DroningOn/ECE411/ECE 411 Presentation/Prototype Button.jpg

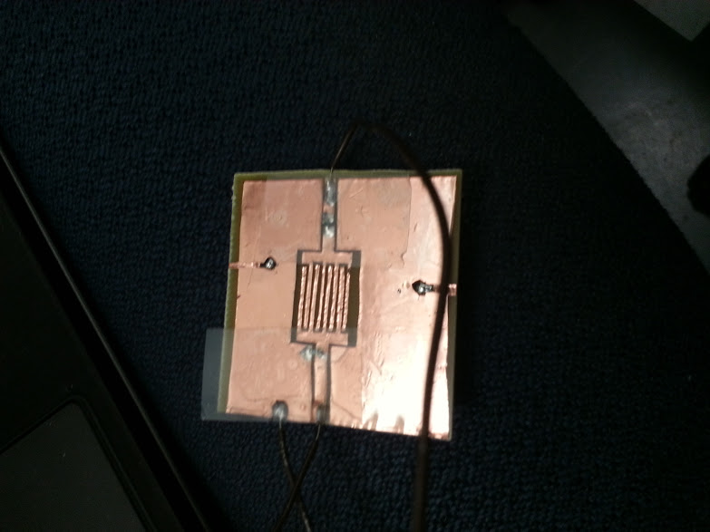
ECE 411 Presentation/Prototype Button.jpg
