DroningOn/ECE411/README.md

ECE411 Practicum Project
========================

**Project Focus:** Classroom Interactive Device

**Team:** Chris Halseth, Kyle Lu, Matt Downey, Michael Schmidt

**Advisor:** Andrew Greenberg

**Schematics and Layout**
(right click, save link as)

* [Satellite Board Schematic] (https://raw.githubusercontent.com/DroningOn/ECE411/master/Eagle/Schematics%20&%20Board%20Layout/Tx%20Board%20Schematic/T08-TxClicker-Rev1a.sch)

* [Satellite Board Layout] (https://raw.githubusercontent.com/DroningOn/ECE411/master/Eagle/Schematics%20&%20Board%20Layout/Tx%20Board%20Schematic/T08-TxClicker-Rev1a.brd)
