DroningOn/ECE411/ECE 411 Presentation/T08Presentation.pptx

## Wireless Classroom Clicker

Portland State University
Team: T08

Notes: Introduce Team:

Kyle Lu Chris Halseth Michael Schmidt Matt Downey

## Slide 2

1
Project Description
2
Motivation
3
Implementation
4
Results

Notes: Key Idea: What are we going to talk about?

## Project Description

  - Classroom Clicker System

ResponseCard NXT

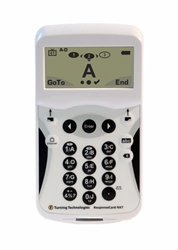
[picture p2: figure]

$59.50

iclicker +

$45

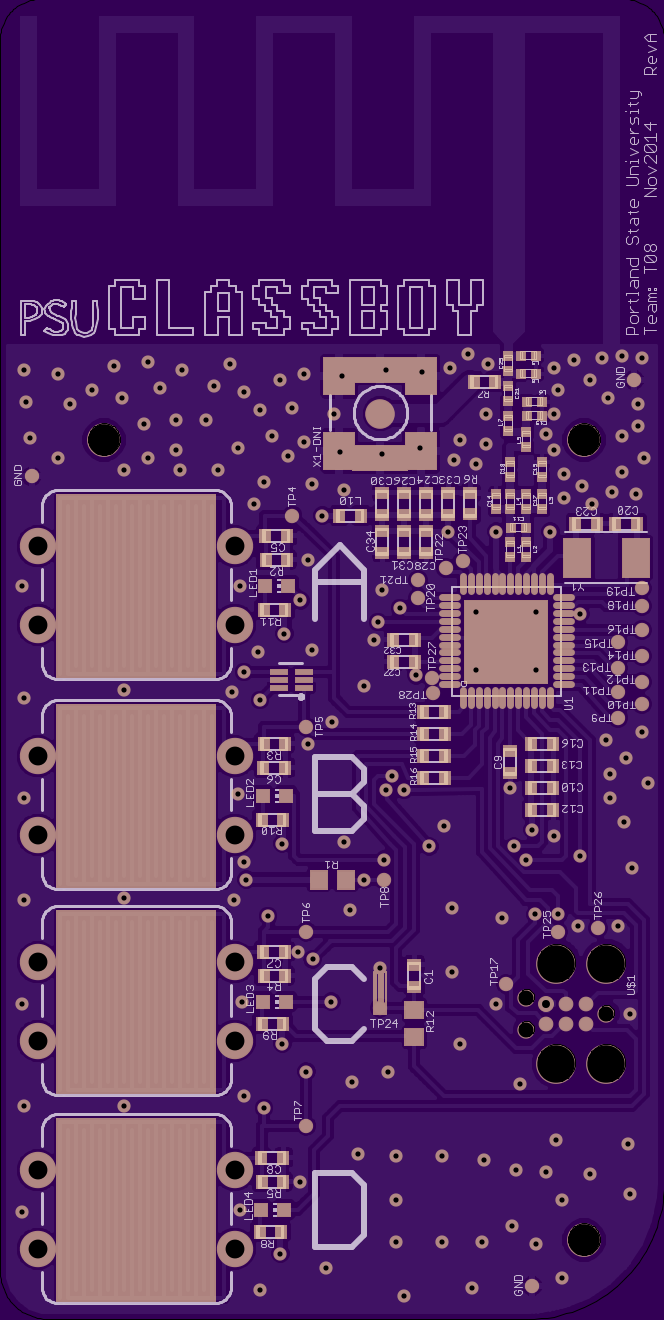
[picture p3: figure]

$9.40

Notes: Key Idea: What is a classroom clicker?

Facilitate real-time feedback system for data polling

## Motivation

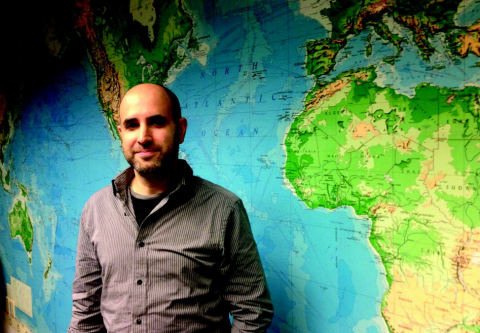
[picture p4: figure]

Notes: Key Idea: Andrew solicited the class to build a system with his specifications

1st week of class

## Requirements

- Primary
  - Cost Sensitive <$15
  - Minimum 100 Simultaneous Devices
  - Reliable: <0.1% Loss of Votes
  - Range: Lecture Hall

Notes: Key Idea: Primary Design Requirements

## Implementation

- Satellite
- Base Station
- Python GUI
  - PC Platform

Notes: Key Idea: Modules that were developed for this system

Long Operational Lifetime
2-Way Radio
ISM Band 915 MHz

## Implementation

- Satellite
- Base Station
- Python GUI
  - PC-Platform

Notes: Key Idea: Modules that were developed for this system

## Implementation

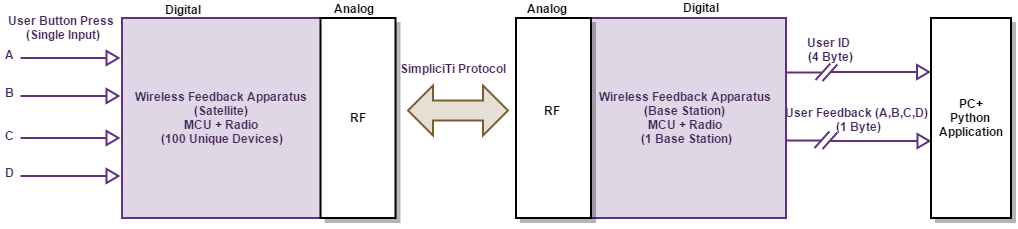
[picture p5: figure]

Notes: Key Idea: Functionality

What are the inputs/outputs
How are we transmitting data

## Satellite Flow Chart

Sleep Till Button Press

Flash All LED

n

Connected

n

Flash 4x LED

Attempt Reconnect

Get ACK

n

y

y

Tried 5 Times

Send Packet

n

y

y

n

CNT Base

Sleep Till Button Press

Form Packet

Send Packet

Get ACK

Init System

Connected

y

Button LED 2x

Notes: Key Idea: Modules that were developed for this system

## Python GUI Flow Chart

INIT Serial Port

Open Excel Workbook

Init GUI

CNT Base

Update Polling Duration

GUI Main Loop

Reset Bar Graph

Open Polling Loop & Init Count

Close Polling Loop

Close GUI, Serial Port, & Workbook

Display Results

Write Totals to Workbook

Count Answers

## Schematic

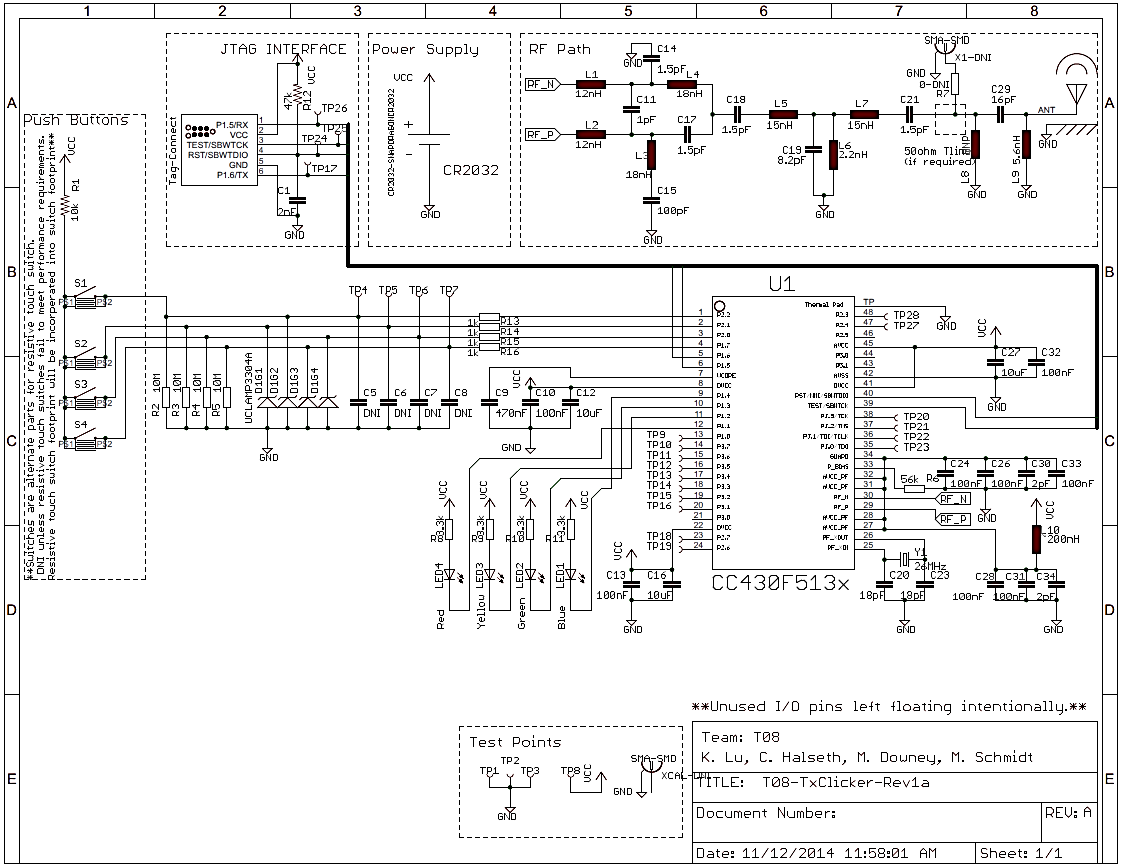
[picture p6: figure]

## Board Layout

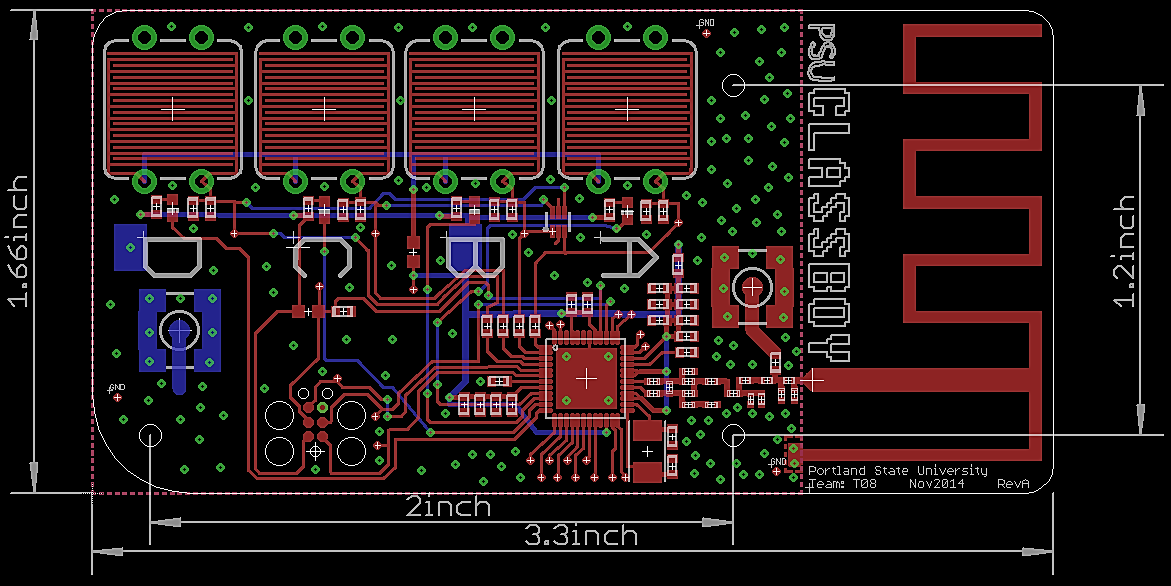
[picture p7: figure]

## Board Layout


## Testing Strategy

- Level 1: Unit Testing
- Level 2: Integrated Testing
- Level 3: System Testing

## Testing Strategy

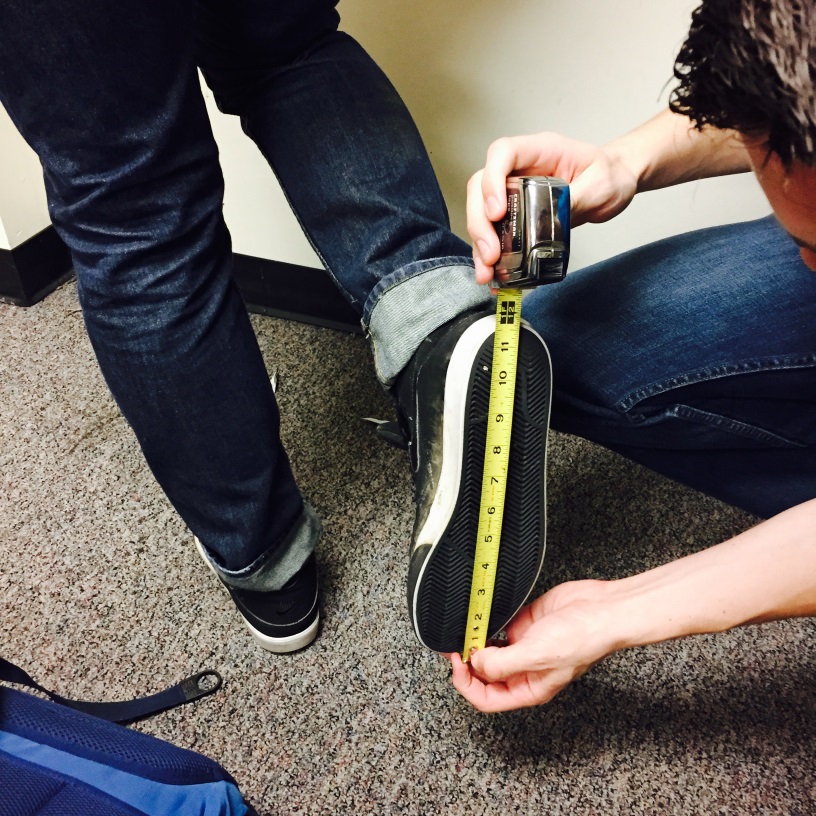
[picture p8: figure]

Notes: 0.96ft /Michaelfoot ~150

## IP and Prior Work

- Python Modules
  - PySerial, Time, CSV, TkInter
- MSPExp430F6137Rx User Experience
- MSPExp430F5137Rx User Experience
- Texas Instruments SimpliciTI Protocol

## Contributions

K. Lu System Level Design Schematic/PCB Layout Construct 4x Boards Bill of Materials Documentation Review | C. Halseth RF Antenna Design Resistive Button Design Base Station Program Satellite Program ~1000 Lines of Code PCB Layout
M. Schmidt Python GUI Development ~380 Lines of Code Developed Export Data Algorithm System Test & Verification | M. Downey System Test & Verification System Documentation Code Review

## Demonstration

- Q1: “wow, such cheap, much click, very engineer, so antenna, wow!”
- Press: A, B, C, or D

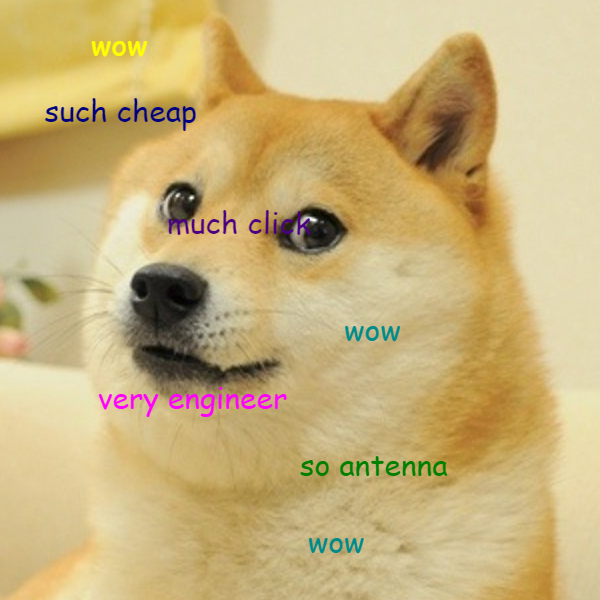
[picture p9: figure]
