DroningOn/ECE411/Antenna_Design/ECE411Antenna_wrk/SimulationLayout.pdf

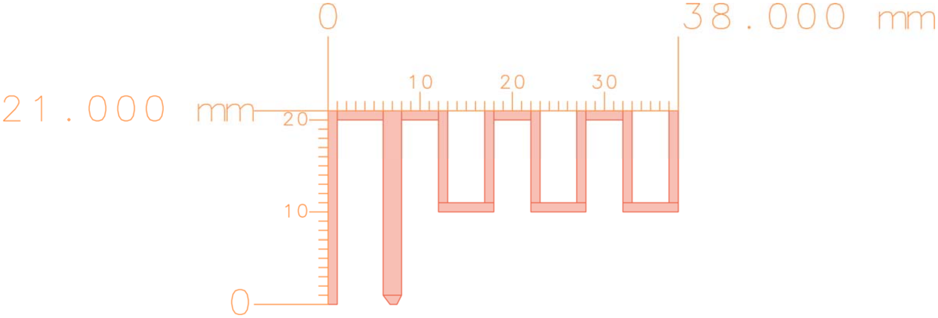
[picture p10: figure]
