DroningOn/ECE411/WikiMaterials/WPR/Team WPR.docx

Chris Halseth

WPR 2014-10-26

Last Week

Designed, simulated PCB antenna and matching network

Implemented full RF section in schematic/layout (chip->balun->match->antenna)

Tested CC430 dev kit functionality (*see issues)

Wrote simple program for turning on/off LED on dev kit with switch using CCS(TI IDE)

Created low cost resistive button prototype, tested on Arduino platform, decent results

Next Week

Isolate emulator/programming interface on dev kit for breakout

Set up dev kit to pass serial information via USB

Implement resistive button prototype in layout

Issues

Dev kit unable to connect wirelessly using demo program, strongly suspect radio is damaged on base board or

satellite. Recommend RMA ASAP so I can hash out/test wireless protocol in functioning environment.

================================================================================

Last Week (2014-11-02)

Isolate emulator/programming interface on dev kit for breakout

Set up dev kit to pass serial information via USB (software written not tested)

Ordered new dev kit

Next Week

Implement resistive button prototype in layout

Test serial interface when dev kit arrives and verify wireless link

Reoptimize antenna with current layout

Issues

Dev kit RMA slowed things down

Competing responsibilities this week pushed layout work out

Need to hash out serial interface data spec so front/back end has a unified design goal

================================================================================

Last Week (2014-11-09)

Layout work..a lot of it. Design finished, shipped.

Implemented resistive button layout.

Re-optimized antenna for current layout.

Setup serial interface on dev kit.

Tested wireless link, failed to connect.

Hashed out rough outline of serial comm spec with team.

Next Week

Isolate wireless connection issue(hopefully fix).

Write interrupt, operation, sleep routine skeleton.

Create fake data spew program for base board to provide a test basis for front end.

Issues

Second dev kit came in, same issue as last. EMI?Requires troubleshooting.

Will need access to a VNA and surface mount SMA launches when boards come in for match network cal.

Time, sleep, moral, etc.

================================================================================

WPR 2014-11-16

Last Week

Isolated wireless network connection issue and fixed.

Created functional skeleton program-- Sleep->ButtonInterrupt->Wake->TX->Verify->Sleep

Used/modified SimpliTI API to create robust network to handle errors and reconnects.

Worked on fake data program (unfinished)

Worked on isolating satellite device address from incoming packets on base station(unfinished)

Scheduled VNA access for Friday 21Nov (antenna verification, matching network optimization)

Next Week

Finish data spew program and pass off

Test antenna on VNA (cross fingers ADS is semi accurate with my models)

Calculate matching network from VNA measurements

Stuff board on Friday

If TagConnect cable shows up finally, program a board and do some verification

Issues

TagConnect cable not here yet.

Three weeks.... lot of unknowns and lots to do.

Isolating device address on incoming packets taking a bit of API/network layer rewrite, time consuming.

Simultaneous device support tests not really possible (eg. we don't have 500) don't know how to test currently besides using a separate device to flood the channel, but this is a bad approximation because it isn't exercising base station handle of many tokens/frame scheduling/etc

================================================================================

WPR 2014-11-23

Last Week

Data spew program cancelled due to priorities, text file substituted

VNA tests on one board, antenna trimmed and match calculated

Two boards stuffed

Hacked together preliminary firmware for satellite, initial tests good(yay network works)

Next Week

Get functional versions of base and satellite code up and running

Troubleshoot issues as they arise

Hand off system for testing

Issues

Bit of a non-issue but noticed the trimmed antenna is worse than untrimmed antenna in RSSI, perhaps VSWR measurement was fouled by proximity of SMA cable port.

================================================================================

Last Week (2014-11-30)

Wrote and tested functional base station code

Wrote and tested functional satellite code

Performed preliminary range tests

Handed off functional satellite/base combo for testing with GUI frontend

Troubleshot button code glitch

Next Week

Get ESD protection on boards

Test/verification/load firmware/(repair if needed) next two boards

Test cases and measurements with batteries installed

Clean up project code and have a team review for it

================================================================================

Last Week (plus most of another, finals) (2014-12-12)

Firmware load/test/verification/repair of other two boards

Test cases and measurements with batteries installed

Cleaned up project code and have a team review for it

Modification to base station to handle 100 devices

Test code created for 100 device verification

Bug squashing on satellites and base station

Sleep between blinks code to save battery implemented

Presentation preparation

Presentation delivered

Mostly maintained sanity

Kyle Lu

Last Week (2014-10-26)

Finished schematic

Completed BOM

Next Week

Order Parts

Order Boards

Issues

Decide on Tag-Connect

Decide on Tx enclosure

====================================================================================

Last Week (2014-11-02)

Started PCB Layout

Edited schematic per suggestions from ADG

Next Week

Finalize PCB layout (due Wednesday)

Finalize BOM

Design for test review

Issues

Delayed Digikey parts order until final board review from team + ADG

====================================================================================

Last week (2014-11-9)
---------------------------------------------------------------------------------------------------------------------------------------------------
Continued working on layout/editing (push-pull-push-pull)
Submitted PCBs to OSH Park.

This week
---------------------------------------------
Order parts
Look at GUI?

====================================================================================

Last Week (2014-11-16)

Ordered Parts

Created System Level 0, Level 1 Diagrams

Created UML Model of Button Press Activity

This Week

Stuff Boards

Debug Boards

Create a Test Plan

Create Validation Documentation

Issues

Must add CR2032 battery costs to BOM

Only 3 weeks left.

====================================================================================

Last Week (2014-11-30)

Formalize test plan documentation

Defined scope of test plan

Linked 'design' documentation

Linked 'other' documentation

Linked FCC & Industry standards documentation

Assigned test case #s

This Week

Stuff two additional boards

Review system documentation & verify req'm are met

Perform test cases & record results

Issues

====================================================================================

Last Week (2014-11-21 post hoc)

Stuffed 2x boards for test & debug

This week

Thanksgiving

Issues

This is a post hoc WPR.

====================================================================================

Last week (2014-12-12)

Prepared presentation

Delivered presentation

Closed outdated action items on github

Went to many ece 411 presentations throughout Thursday and Friday.

Downloaded and installed gui on multiple computers to ensure that it works on different machines.

Issues

Failed to meet sleeping requirements.

Failed some coffee requirements.

Finals or presentations every day (except) Thursday.

Michael Schmidt

WPR 2014-10-26

Last Week

Researched feasibility of wxPython as GUI dev wrapper

Researched Pyserial module for serial com to base station

Next Week

Prototype wxPython GUI

Attempt serial communication using Pyserial module

Order CR2032 batteries for transmitters

====================================================================================

WPR 2014-11-03

Last week
------------------------------
- Switched from wxPython to Tkinter for GUI development
- Successfully prototyped GUI module that displays data in a bar graph
- Decided on pyusb module for reading data over usb

Next Week
-----------------------
- Work on project schedule with Matt
- Further research pyusb
- Run a usb "Hello, World!" with pyusb

====================================================================================

WPR 2014-11-12

Last Week

- Write, Review and Revise project schedule

- Further GUI Research

This Week

-Finalize GUI Layout

-Begin writing GUI functions

-Research packet format from base station

-Begin packet parser pseudocode

====================================================================================

WPR 2014-11-16

Last Week

Wrote Model and System Diagram Doc

Finished Pseudocode for Parser

Wrote rev 1 of software application

Started preliminary testing of software application

Next Week

Write test plan

Add additional GUI elements

Test parser with Chris's data spew program

Write rev 2 of software application

====================================================================================

WPR 2014-11-23

Last Week

Test parser

Add GUI elements

This Week

Added GUI widgets

Create event handlers for widgets

Write poll loop

Test plan

====================================================================================

WPR 2014-11-30

Last Week
--------------------------
-Added GUI widgets (start button, stop button, countdown timer, percentages on bar graph, drop down for polling duration)
-Implemented event handlers for all widgets
-Rewrote newParse method to include polling loop.
-Successfully interfaced software application with base station
-Assist in writing test plan

This week
---------------------
-Implement file output in software application (.csv or .xslx)
-Add different graph methods (horizontal bar, pie chart)
-Clean up code and finish comments
-Execute test plan to verify requirements

====================================================================================

WPR 2014-12-7

Last week

- Added excel readable csv output

- clean up code and added comment

- Some testing

This Week

- Finish testing

- Finish commenting

- Work on presentation

- Present !

====================================================================================

WPR 2014-12-12

Last Week
----------------------
Finalized GUI
Finished testing
Prepared Presentation
Delivered Presentation
Done!

Matt Downey

WPR 2014-10-26

Last Week

Researched GUI language options

Conducted GUI concept discussion with Kyle

Next Week

Conduct feasibility of GUI languages compatibility to MCU (wrappers)

RMA dev kit

Continue GUI concept discussions

=========================================================================================

WPR 2014-11-2

Last week

Resolved dev kit RMA issues. Chris to buy new part, Matt to get money back for original.

Assisted in completion of PDS report.

Next week

Conceptual layout of GUII

Assist in project timeline

========================================================================================

WPR 2014-11-12

Last week

Assisted with creation of project timeline documentation

Initiated team conversation about serial comm spec with team

Suggested contact with Dr. Campbell for access to VNA

Next Week

Code party with Michael

System Design and Model documentation

========================================================================================

WPR 2014-11-30

Last Week

Wrote parts of test plan.

Reviewed and Revised Test plan.

Next Week

Final Thursday 12/4

Complete tests to prove Design Specs

Group Meeting Saturday 1pm
