DroningOn/ECE411/WikiMaterials/HWDocuments/ECE411HW6.pdf

### ECE 411 Industry Design Processes: Assignment #6 Due on Monday, November 24, 2014 Faust 2:00pm

T08

### K. Lu, C. Halseth, M. Schmidt, M. Downey

https://github.com/DroningOn/ECE411

Homework #6 Due Monday November 24, 2014 ***Please submit problems into the team wiki homework #6 folder on GitHub as well as a paper copy in class.***

Grading Schema:
Your work will be graded on completeness, conformance to design documentation requirements as described in class, and quality and clarity of the individual test cases.

Problem 1:
Create a comprehensive hierarchical test plan for your practicum project. Consult the course lecture notes and textbook for guidelines.

# Wireless Feedback Apparatus

Test Plan Documentation

Rev. 201411.R1

The information presented in the T08 test documentation in the alpha phase of development. Although this document has been carefully checked and is believed to be accurate, no responsibility is assumed for inaccuracies.

Introduction
In Scope
Out of Scope
Reference Documents
Design Documentation
Other Documentation
Overview of Testing Approach Levels of Testing
Level 1: Unit Testing
Level 2: Integrated Testing Level 3: System Testing
Testing Definitions
Operational Description
Definition of Terminology
Computation Methods
Pretest Preparation
Test Equipment
Test Setup and Calibration
System Tests
Level 1: Unit Testing
L1-F01-A-A: Visual Inspection of reflowed boards L1-F02-A-A: Radio Frequency ISM Band Test L1-F03-A-A: Current Consumption Test L1-F04-A-A: MCU LED Response Test L1-F05-A-A: GUI Functionality Test L1-P01-A-A: RF Scattering Parameters L1-P02-A-A: RSSI
L1-P03-A-A: Power output (dBm) L1-R01-A-A: Button Press Counter L1-R02-A-A: Tx Packet Counter L1-R03-A-A: Real-Time Packet Parsing L1-R04-A-A: Data Storage Validation Test
Level 2: Integration Testing
L2-F01-A-A: Transmit Packet Test
L2-F02-A-A: Integrated Power Consumption Test L2-F03-A-A: Return to Sleep Mode Test L2-F04-A-A: Populate Network Test L2-F05-A-A: Interface Python GUI to Base Station L2-F06-A-A: Connect to Network on Reset L2-F07-A-A: Connect to Network on Power Up L2-F08-A-A: Connect to Network after Loss of Power L2-P01-A-A: RSSI

L2-P02-A-A: Connectivity
Level 3: System Testing
L3-F01-A-A: Button Press Indicator L3-F02-A-A: Usability Test L3-F03-A-A: End to End Hardware L3-F04-A-A: GUI Statistics Report L3-F05-A-A: GUI Start/Stop Polling L3-F06-A-A: GUI New Dataset L3-T01-A-A: User Input Test L3-T02-A-A: Ease of Use Test
L3-R01-A-A: Repeatability Test
L3-R02-A-A: Battery Lifetime
L3-R03-A-A: Channel Noise Connectivity Test

## 1. Introduction

The purpose of the product test plan is to document how the product will be tested to ensure that it conforms to the project scope and meets the engineering requirements specified in the Product Design Specification (PDS) document.

In Scope
This document addresses the procedures necessary for proper system testing and verification related to the design of the wireless classroom feedback product. The product testing plan includes the following modules described in detail by the PDS.
- Operational Requirements
- Functionality Requirements
- Performance Requirements
- Interface Requirements
Out of Scope
The following items are outside of the scope of the initial project and may be addressed by subsequent practicum design projects.
- Verification of all FCC regulations pertaining to short-range wireless communication devices (47CFR20).
- Characterization of antenna directivity and radiation efficiency
- Six-Sigma Testing Methodology

## 2. Reference Documents

Refer to the following reference documentation for the detailed documentation about specific testing guidelines and standards.

### 2.1. Industry Standards

- FCC guidelines, Radiofrequency radiation exposure limits. (http://www.ecfr.gov/cgi-bin/text-idx?SID=5cafd53f1d764142f00e1b9f3a8ddcdf&node=se47.1.1_11310&rgn=div8)
- (47CFR1.1310)
- FCC Regulations, Title 47- Telecommunications (http://www.fcc.gov/encyclopedia/rules-regulations-title-47)
- (47CFR20)

### 2.2. Design Documentation

- Product Design Specifications (PDS) (https://github.com/DroningOn/ECE411/blob/master/WikiMaterials/HWDocuments/ECE411T08HW3.pdf?raw=true)
- Block Level Diagram Document ( System Design / Modeling Document) (https://github.com/DroningOn/ECE411/blob/master/WikiMaterials/HWDocuments/ECE411T08HW5.pdf?raw=true)
- Eagle Circuit Schematic (https://raw.githubusercontent.com/DroningOn/ECE411/master/Eagle/Schematics%20&%20Board%20Layout/Tx%20Board%20Schematic/T08-TxClicker-Rev1a.sch)
- Eagle Board Layout (https://raw.githubusercontent.com/DroningOn/ECE411/master/Eagle/Schematics%20&%20Board%20Layout/Tx%20Board%20Schematic/T08-TxClicker-Rev1a.brd)

- Top/Bot Layer Reference (https://github.com/DroningOn/ECE411/blob/master/WikiMaterials/HWDocuments/ECE411T08HW6/Eagle%20Reference%20Docs/T08-TxClicker-Rev1a-top.pdf)
- Bot Layer Reference (https://github.com/DroningOn/ECE411/blob/master/WikiMaterials/HWDocuments/ECE411T08HW6/Eagle%20Reference%20Docs/T08-TxClicker-Rev1a-bot.pdf)
- Dimensions Layer Reference (https://github.com/DroningOn/ECE411/blob/master/WikiMaterials/HWDocuments/ECE411T08HW6/Eagle%20Reference%20Docs/T08-TxClicker-Rev1a-Dimensions.pdf)
- Component Outline Reference (https://github.com/DroningOn/ECE411/blob/master/WikiMaterials/HWDocuments/ECE411T08HW6/Eagle%20Reference%20Docs/T08-TxClicker-Rev1a-ComponentOutline.pdf)
- Bill of Materials (BOM) (https://github.com/DroningOn/ECE411/blob/master/Eagle/Schematics%20%26%20Board%20Layout/Tx%20Board%20Schematic/T08-TxClicker_BOM.xlsx)

### 2.3. Other Documentation

- Texas Instruments: SLAA276A-October 2006 (https://github.com/DroningOn/ECE411/blob/master/Active%20Datasheets/CC430%20to%20USB.pdf)
- Texas Instruments: ECCN 5A002A1A (https://github.com/DroningOn/ECE411/blob/master/Active%20Datasheets/CC430_DevKit_UserGuide.pdf)
- Texas Instruments: SLAA465C (https://github.com/DroningOn/ECE411/blob/master/Active%20Datasheets/CC430_RF_Examples.pdf)
- Texas Instruments: SLAU320P (https://github.com/DroningOn/ECE411/blob/master/Active%20Datasheets/MSP430%20Programming%20Via%20the%20JTAG%20Interface.pdf)
- Texas Instruments: DN024 (https://github.com/DroningOn/ECE411/blob/master/Active%20Datasheets/PCB_Antenna.pdf)
- Texas Instruments: Introduction to SimpliciTI (https://github.com/DroningOn/ECE411/blob/master/Active%20Datasheets/SimplicitiNetwork.pdf)
- Texas Instruments: SmartRF Studio (https://github.com/DroningOn/ECE411/blob/master/Active%20Datasheets/SmartRFStudio_Tutorial.pdf)
- Texas Instruments: CC430F5137 (https://github.com/DroningOn/ECE411/blob/master/Active%20Datasheets/cc430f5137.pdf)

## 3. Overview of Testing Approach

### 3.1. Levels of Testing

Levels of testing are implemented to detect and identify problems early in the product development cycle. By modularizing testing, many components may be verified and tested in parallel thereby speeding up product development and reducing development time kinks where teams or team members are left idle. Each level must first be validated and approved by the team or manager before elevating the test to the next level. In this document, three levels of testing are implemented. Each level as well as the test level objects are defined below.

### 3.1.1. Level 1: Unit Testing

This phase involves testing independent pieces of hardware and software. The unit test is performed to validate the design requirements specified in the PDS. Unit testing generally represents a single aspect of the design and is an easy way to show that the unit satisfies its functional specification.
- Objectives
- Perform detailed tests of all functional requirements
- “White” box testing passes
- “Black” box testing passes
- Meets all specifications described by PDS

### 3.1.2. Level 2: Integrated Testing

The integrated testing phase integrates unit modules in order to create more complex components. The purpose of this test is to discover whether the major modules of the overall system operate correctly together.

- Objectives
- Verify that performance specifications are maintained during integration phase
- Identify and fix problems prior to system testing

### 3.1.3. Level 3: System Testing

The system level test is used to determine if the product functions as specified by the PDS. In this phase, testers identify problems encountered in functionality where a given functional input does not produce the expected response.
- Objectives
- Ensure end device operates as expected and matches the intention of the design specification.
- Verify that functional and performance specifications are met.
- Verify that all items on test plan are performed successfully.
- Identify problems with the data

### 3.2. Operational Description

- Takes 1 of 4 user inputs and wirelessly transmits the selected input to a central hub where a results are serialized and handed off to software. The software takes the serialized data and displays it in graphical form.

### 3.3. Definition of Terminology

### 1. MCU : Microcontroller Unit 2. ID : Identification 3. DUT : Device Under Test 4. GUI : Graphical User Interface

5. Exhaustive Test: Testing approach in which all possible combinations of scenarios, use cases, and test cases are used in testing
6. Battery Lifetime: Total duration that a satellite unit can operate on a single, fully-charged CR2032 battery.
7. ISM Band Region 2: The unlicensed band from 902MHz to 928MHz.

### 3.4. Computation Methods

### 3.4.1. Power Consumption

- Device Current Consumption:
- Iaverage = I | x Ratio | x Ratio | I | x Ratio Standby | Standby
+ IActive | active + Peripheral | Peripheral
- Total Average Current Consumption:
- AvgI | AvgI | AvgI | vgI
total = | Standby
+ | Peripheral + A Active
- Battery Lifetime
- CR2032 uAh/AvgI
| total
■ 230000uAh/AvgI
| | | | | total

## 4. Pretest Preparation

### 4.1. Test Equipment

- Agilent Vector Network Analyzer
- Agilent 2-Channel Oscilloscope
- Fluke Multimeter
- Computer with Python installed
- Keithly Micro-ammeter
- CC430 DevKit
- ECE 411 Project Satellite Unit
- Base Station

### 4.2. Test Setup and Calibration

- Load firmware to MCU
- Install CR2032 to power Satellite unit
- Install “serial” and “Tkinter” python module

## 5. System Tests

The system TestID format shall be as follows: Level# - X(Test Type) Level#-TestTypeLetter XX - HardwareRev-Software Rev
- Level 1: Unit Testing
- Functional Testing
■ L1-F01-A-A: Visual Inspection of reflowed boards ■ L1-F02-A-A: Radio Frequency ISM Band Test ■ L1-F03-A-A: Current Consumption Test
■ L1-F04-A-A: MCU LED Response Test
■ L1-F05-A-A: GUI Functionality Test
- Parametric Testing
■ L1-P01-A-A: RF Scattering Parameters ■ L1-P02-A-A: RSSI
■ L1-P03-A-A: Power output (dBm)
- Reliability Testing
■ L1-R01-A-A: Button Press Counter
■ L1-R02-A-A: Tx Packet Counter
■ L1-R03-A-A: Real-Time Packet Parsing
■ L1-R04-A-A: Data Storage Validation Test

- Level 2: Integration Testing
- Functional Testing
■ L2-F01-A-A: Transmit Packet Test
■ L2-F02-A-A: Integrated Power Consumption Test ■ L2-F03-A-A: Return to Sleep Mode Test
■ L2-F04-A-A: Populate Network Test
■ L2-F05-A-A: Interface Python GUI to Base Station ■ L2-F06-A-A: Connect to Network on Reset
■ L2-F07-A-A: Connect to Network on Power Up
■ L2-F08-A-A: Connect to Network after Loss of Power
- Parametric Testing
■ L2-P01-A-A: RSSI
■ L2-P02-A-A: Connectivity
- Level 3: System Testing
- Functional Testing
■ L3-F01-A-A: Button Press Indicator ■ L3-F02-A-A: Usability Test
■ L3-F03-A-A: End to End Hardware ■ L3-F04-A-A: GUI Statistics Report ■ L3-F05-A-A: GUI Start/Stop Polling ■ L3-F06-A-A: GUI New Dataset
- Use Testing
■ L3-T01-A-A: User Input Test
■ L3-T02-A-A: Ease of Use Test
- Reliability Testing
■ L3-R01-A-A: Repeatability Test
■ L3-R02-A-A: Battery Lifetime
■ L3-R03-A-A: Channel Noise Connectivity Test

Problem 2:
Create detailed test case descriptions for four tests included in your test plan.

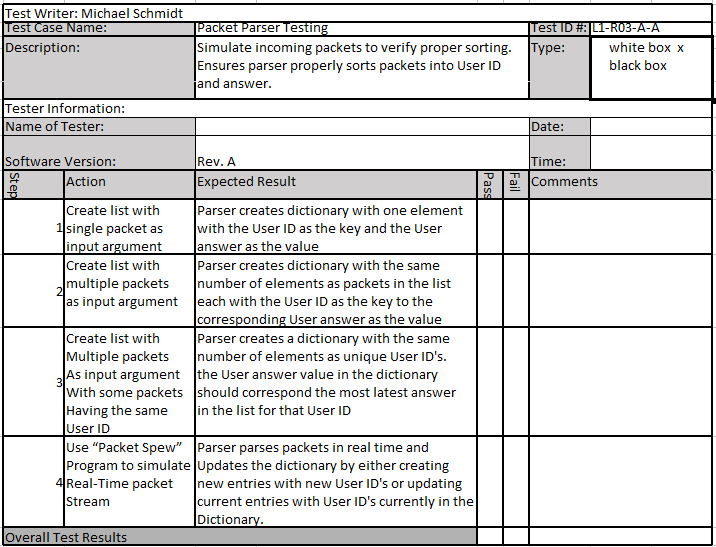
[picture p11: figure]

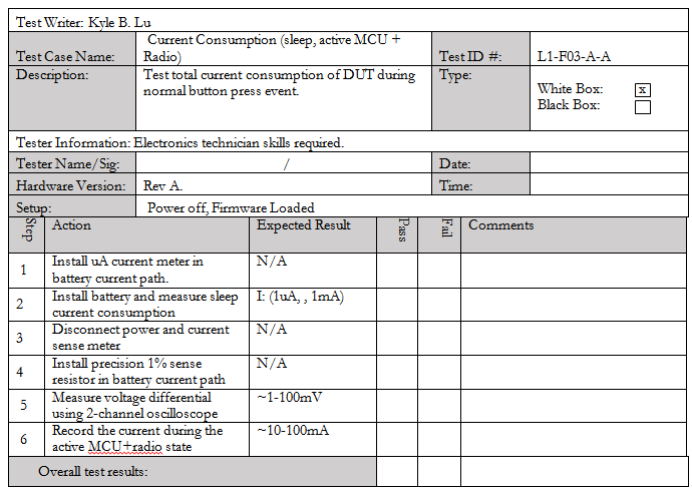
[picture p12: figure]

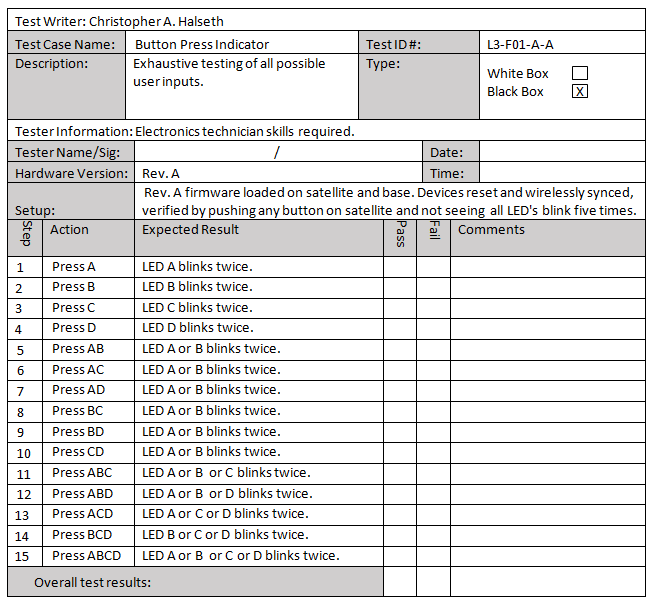
[picture p13: figure]

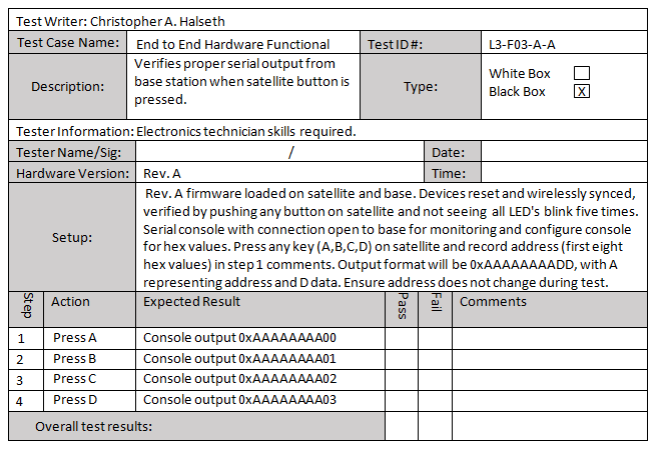
[picture p14: figure]
