DroningOn/ECE411/BOM/T08-TxClicker_BOM.xlsx

Sheet: T08-TxClicker_Rev1a
ECE 411 "Clicker" BOM, T08
Number of Boards | 4
Total Components/Build | Qty | Value | Parts | Description | Digikey# | Manufacturer | Manufacturer P/N | Unit Price | Extended Price @100x
112 | 28 |  | TP1, TP2, TP3,TP4, TP5, TP6, TP7, TP8, TP9, TP10, TP11, TP12, TP13, TP14, TP15, TP16, TP17, TP18, TP19, TP20, TP21, TP22, TP23, TP24, TP25, TP26, TP27, TP28 | COPPER TEST POINTS
16 | 4 | 1.5pF | C14, C17, C18, C21 | CAP CER 1.5PF 50V NP0 0402 | 490-5891-1-ND | Murata Electronics North America (http://digikey.com/Suppliers/us/Murata-Electronics.page?lang=en) | GRM1555C1H1R5CA01D | 0.1 | 0.011
32 | 8 | 100nF | C10, C13, C24, C26, C28, C31, C32, C33 | CAP CER 0.1UF 50V 10% X7R 0603 | 399-5089-1-ND | Kemet (http://digikey.com/Suppliers/us/Kemet.page?lang=en) | C0603C104K5RACTU | 0.1 | 0.0187
4 | 1 | 100pF | C15 | CAP CER 100PF 50V 1% C0G 0402 | 445-5362-1-ND | TDK Corporation | C1005C0G1H101F050BA | 0.45 | 0.1964
16 | 4 | 10M | R2, R3, R4, R5 | RES 10M OHM 1/10W 5% 0603 | RMCF0603JT10M0CT-ND | Panasonic Electronic Components | RMCF0603JT10M0 | 0.1 | 0.007
4 | 1 | 10k | R1 | RES 10K OHM 1/10W 1% 0603 | RMCF0603FT10K0CT-ND | Stackpole Electronics Inc | RMCF0603FT10K0 | 0.1 | 0.0105
12 | 3 | 10uF | C12, C16, C27 | CAP CER 10UF 16V 20% X5R 0603 | 490-7201-1-ND | Murata Electronics North America (http://digikey.com/Suppliers/us/Murata-Electronics.page?lang=en) | GRM188R61C106MA73D | 0.3 | 0.1967
8 | 2 | 12nH | L1, L2 | FIXED IND 12NH 640MA 120 MOHM | 732-1725-1-ND | Wurth Electronics Inc (http://digikey.com/Suppliers/us/Wurth-Electronics.page?lang=en) | 744765112A | 0.47 | 0.375
8 | 2 | 15nH | L5, L7 | FIXED IND 15NH 560MA 172 MOHM | 732-1727-1-ND | Wurth Electronics Inc (http://digikey.com/Suppliers/us/Wurth-Electronics.page?lang=en) | 744765115A | 0.47 | 0.375
4 | 1 | 16pF | C29 | CAP CER 16PF 50V 1% NP0 0402 | 399-8829-1-ND | Kemet | CBR04C160F5GAC | 0.34 | 0.1412
8 | 2 | 18nH | L3, L4 | FIXED IND 18NH 420MA 230 MOHM | 732-1729-1-ND | Wurth Electronics Inc (http://digikey.com/Suppliers/us/Wurth-Electronics.page?lang=en) | 744765118A | 0.47 | 0.435
8 | 2 | 18pF | C20, C23 | CAP CER 18PF 50V 1% NP0 0603 | 1276-2206-1-ND | Samsung Electro-Mechanics America, Inc (http://digikey.com/Suppliers/us/samsung-electro-mechanics.page?lang=en) | CL10C180FB8NNNC | 0.16 | 0.0527
16 | 4 | 1k | R13, R14, R15, R16 | RES 1K OHM 1/10W 1% 0603 SMD | P1.00KHCT-ND | Panasonic Electronic Components | ERJ-3EKF1001V | 0.1 | 0.0114
4 | 1 | 1pF | C11 | CAP CER 1PF 50V NP0 0402 | 1276-1595-1-ND | Samsung Electro-Mechanics America, Inc (http://digikey.com/Suppliers/us/samsung-electro-mechanics.page?lang=en) | CL05C010CB5NNNC | 0.1 | 0.0096
4 | 1 | 2.2nH | L6 | FIXED IND 2.2NH 960MA 70 MOHM | 732-1706-1-ND | Wurth Electronics Inc (http://digikey.com/Suppliers/us/Wurth-Electronics.page?lang=en) | 744765022A | 0.47 | 0.375
4 | 1 | 26MHz | Y1 | CRYSTAL 26MHZ 18PF SMD | 887-1508-1-ND | TXC CORPORATION (http://digikey.com/Suppliers/us/TXC-Corporation.page?lang=en) | 7A-26.000MAAJ-T | 0.79 | 0.525
4 | 1 | 2nF | C1 | CAP CER 2000PF 50V 5% NP0 0603 | 490-1458-1-ND | Murata Electronics North America (http://digikey.com/Suppliers/us/Murata-Electronics.page?lang=en) | GRM1885C1H202JA01D | 0.13 | 0.0428
8 | 2 | 2pF | C30, C34 | CAP CER MLO 2PF 50V NP0 0603 | 478-6717-1-ND | AVX Corporation | ML03512R0BAT2A | 0.6 | 0.2763
16 | 4 | 3.3k | R8, R9, R10, R11 | RES 3.3K OHM 1/10W 1% 0603 | RMCF0603FT3K30CT-ND | Stackpole Electronics Inc | RMCF0603FT3K30 | 0.1 | 0.0105
4 | 1 | 470nF | C9 | CAP CER 0.47UF 50V 10% X5R 0603 | 587-3171-1-ND | Taiyo Yuden | UMK107ABJ474KA-T | 0.11 | 0.0381
4 | 1 | 47k | R12 | RES 47K OHM 1/10W 1% 0603 | RMCF0603FT47K0CT-ND | Stackpole Electronics Inc | RMCF0603FT47K0 | 0.1 | 0.0105
4 | 1 | 5.6nH | L9 | FIXED IND 5.6NH 280MA 700 MOHM | 732-2921-1-ND | Wurth Electronics Inc (http://digikey.com/Suppliers/us/Wurth-Electronics.page?lang=en) | 744901056 | 0.38 | 0.2438
4 | 1 | 56k | R6 | RES 56K OHM 1/10W 1% 0603 | RMCF0603FT56K0CT-ND | Stackpole Electronics Inc | RMCF0603FT56K0 | 0.1 | 0.0105
4 | 1 | 8.2pF | C19 | CAP CER 8.2PF 50V NP0 0402 | 587-1946-1-ND | Taiyo Yuden (http://digikey.com/Suppliers/us/Taiyo-Yuden.page?lang=en) | UMK105CG8R2DV-F | 0.1 | 0.0099
4 | 1 | CC430F513X---RGZ48 | U1 | IC MCU 16B 32K W/RF CORE 48VQFN | 296-27420-1-ND | Texas Instruments | CC430F5137IRGZR | 6.97 | 2.96
4 | 1 | CR2032-SNAPDRAGONCR2032 | U$5 | HOLDER SNAP DRAGON CR2032 SMD | BHSD-2032-SMCT-ND | MPD (Memory Protection Devices) (http://digikey.com/Suppliers/us/Memory-Protection-Devices.page?lang=en) | BHSD-2032-SM | 0.9 | 0.7875
4 | 1 | Yellow | LED3 | LED YELLOW CLEAR THIN 0603 SMD | 160-1448-1-ND | Lite-On Inc (http://digikey.com/Suppliers/us/Lite-On.page?lang=en) | LTST-C191KSKT | 0.32 | 0.135
4 | 1 | Blue | LED1 | LED 1.6X0.8 470NM BL WTR CLR SMD | 754-1434-1-ND | Kingbright (http://digikey.com/Suppliers/us/Kingbright.page?lang=en) | APT1608QBC/D | 0.39 | 0.2113
4 | 1 | Green | LED2 | LED GREEN CLEAR THIN 0603 SMD | 160-1446-1-ND | Lite-On Inc (http://digikey.com/Suppliers/us/Lite-On.page?lang=en) | LTST-C191KGKT | 0.3 | 0.1296
4 | 1 | Red | LED4 | LED CHIPLED 633NM RED 0603 SMD | 475-2512-1-ND | OSRAM Opto Semiconductors Inc (http://digikey.com/Suppliers/us/Osram.page?lang=en) | LS Q976-NR-1 | 0.09 | 0.587
4 | 1 | PCB_ANTENNA_915MHZOSHP | U$6
8 | 2 | SMA-SMD | X1-DNI, XCAL-DNI | SMA 50 Ohm Straight Jack Receptacle - Surface Mount | CONSMA001-SMD-G-ND | Linx Technologies Inc (http://digikey.com/Suppliers/us/Linx-Technologies.page?lang=en) | CONSMA001-SMD-G | 2.86
4 | 1 | TC2030-MCP | U$1 | TAG-CONNECT ISP
16 | 4 | TOUCHPAD_SWITCH | S1, S2, S3, S4 | INTEGRATED PCB RESISTIVE SWITCH
4 | 1 | UCLAMP3304A | D1 | TVS DIODE 3.3VWM 8VC SC896 | UCLAMP3304ACT-ND | Semtech (http://digikey.com/Suppliers/us/Semtech.page?lang=en) | UCLAMP3304A.TCT | 0.57 | 0.33
4 | 1 | ~200nH | L10 | FIXED IND 200NH 120MA 2.4 OHM | 490-6929-1-ND | Murata Electronics North America (http://digikey.com/Suppliers/us/Murata-Electronics.page?lang=en) | LQW18ANR20G00D | 0.36 | 0.234
1 | PCB | N/A | OSH PARK Board/MyroPCB | N/A |  |  | 1 | 6.75 | 0.63
 | @1x Production | @100x Production
Total Cost | 22.89 | 9.3966

Sheet: T08-TxClicker
Qty | Value | Device | Package | Parts | Description | Digikey# | Mouser | Manufacturer | Manufacturer P/N | Unit Price | Extended Price @100x | Total Cost 100x | Total Cost 1x
1 | CC430F513X---RGZ48 | CC430F513X---RGZ48 | RGZ48 | U1 | ***CC430F513X***RGZ48 ** | (See Arrow Electronics, CC430F5137IRGZ) |  | Texas Instruments | CC430F5137IRGZ | 4.18 | 2.96 | 2.96 | 6.75
1 | 3.3k | R603X42012 | 2012(4_RES) | R2 | RES ARRAY 3.3K OHM 4 RES 2012 | MNR34332CT-ND |  | Rohm Semiconductor | MNR34J5ABJ332 | 0.3 | 0.0984 | 0.0984 | 0.3
1 | CR2032-SNAPDRAGON | CR2032-SNAPDRAGON | CR2032-SNAPDRAGON | U$2 | HOLDER SNAP DRAGON CR2032 SMD | BHSD-2032-SMCT-ND |  | MPD (Memory Protection Devices) | BHSD-2032-SM | 0.9 | 0.7875 | 0.7875 | 0.9
6.125 | PCB | N/A | N/A | N/A | OSH PARK Board | N/A |  |  |  | 1 |  | 0.63 | 6.125
2 | 2pF | C0603 | C0603 | C6, C7, C8, C17, C19 | CAP CER MLO 2PF 50V NP0 0603 | 478-6717-1-ND |  | AVX Corporation | ML03512R0BAT2A | 0.6 | 0.2763 | 0.5526 | 1.2
1 | 9C-26.000MEEJ-T | CRYSTALHC49US | HC49US | Y1 | CRYSTAL 26MHZ 18PF SMD | 887-1508-1-ND |  | TXC Corporation | 7A-26.000MAAJ-T | 0.79 | 0.525 | 0.525 | 0.79
4 | 10uF | C-EUC0603 | C0603 | C1, C2, C4, C11 | CAP CER 10UF 10V 20% X7R 0805 | 587-3417-1-ND |  | Taiyo Yuden | LMK212AB7106MG-T | 0.33 | 0.1162 | 0.4648 | 1.32
1 | 1pF | C0402 | C0402 | C23 | CAP CER 1PF 50V NP0 0402 | 1276-1595-1-ND |  | Samsung Electro-Mechanics America, Inc | CL05C010CB5NNNC | 0.1 | 0.0079 | 0.0079 | 0.1
1 | ESDA6V1-5M6 | ESDA6V1-5M6 | 5X-TVS | U$6 | TVS DIODE 3VWM 6QFN | 497-5779-1-ND |  | STMicroelectronics | ESDA6V1-5M6 | 0.62 | 0.3893 | 0.3893 | 0.62
2 | DMN63D8LDW | DMN63D8LDW | SOT363 | Q1, Q2 | MOSFET 2N-CH 30V 220MA SOT363 | DMN63D8LDW-7CT-ND |  | Diodes Incorporated | DMN63D8LDW-7 | 0.32 | 0.1615 | 0.323 | 0.64
2 | 18pF | C-EUC0402 | C0402 | C13, C14 | CAP CER 18PF 50V 1% NP0 0402 | 399-8828-1-ND |  | Kemet | CBR04C180F5GAC | 0.35 | 0.144 | 0.288 | 0.7
1 | 8.2pF | C0402 | C0402 | C28 | CAP CER 8.2PF 50V NP0 0402 | 587-1946-1-ND |  | Taiyo Yuden | UMK105CG8R2DV-F | 0.1 | 0.0099 | 0.0099 | 0.1
1 |  | LEDCHIP-LED0603 |  | Green | LED 1.6X0.8 470NM BL WTR GRN SMD |  | 604-APT1608MGC | Kingbright | APT1608MGC | 0.5 | 0.256 | 0.256 | 0.5
2 | 12nH | LL0603 | L0603 | L1, L2 | FIXED IND 12NH 400MA 350 MOHM | PCD2003CT-ND |  | Panasonic Electronic Components | ELJ-RE12NGFA | 0.14 | 0.1141 | 0.2282 | 0.28
2 | 15nH | LL0603 | L0603 | L5, L7 | FIXED IND 15NH 350MA 410 MOHM | PCD2004CT-ND |  | Panasonic Electronic Components | ELJ-RE15NGFA | 0.14 | 0.1141 | 0.2282 | 0.28
2 | 18nH | LL0603 | L0603 | L3, L4 | FIXED IND 18NH 350MA 450 MOHM | PCD2005CT-ND |  | Panasonic Electronic Components | ELJ-RE18NGFA | 0.14 | 0.1141 | 0.2282 | 0.28
4 | 1.5pF | C0402 | C0402 | C25, C26, C27, C29 | CAP CER 1.5PF 50V NP0 0402 | 490-5891-1-ND |  | Murata Electronics North America | GRM1555C1H1R5CA01D | 0.1 | 0.011 | 0.044 | 0.4
9 | 100nF | C-EUC0603 | C0603 | C3, C5, C10, C12, C15, C16, C18, C20, C21 | CAP CER 0.1UF 50V 10% X7R 0603 | 399-5089-1-ND |  | Kemet | C0603C104K5RACTU | 0.1 | 0.0187 | 0.1683 | 0.9
1 | 100pF | C0603 | C0603 | C24 | CAP CER 100PF 50V 1% NP0 0603 | 399-7819-1-ND |  | Kemet | C0603C101F5GACTU | 0.39 | 0.162 | 0.162 | 0.39
1 |  | LEDCHIP-LED0603 |  | Blue | LED 1.6X0.8 470NM BL WTR BLUE SMD | 754-1434-1-ND | 604-APT1608QBC/D | Kingbright | APT1608QBC/D | 0.33 | 0.149 | 0.149 | 0.33
1 |  | PINHD-1X6 | 1X06 | JTAG | SIL VERTICAL PC TAIL PIN HEADER | 952-2270-ND |  | Harwin Inc | M20-9990646 | 0.23 | 0.1482 | 0.1482 | 0.23
1 | 5.6nH | LL0603 | L0603 | L8 | FIXED IND 5.6NH 430MA 180 MOHM | PCD1999CT-ND |  | Panasonic Electronic Components | ELJ-RE5N6ZFA | 0.14 | 0.1141 | 0.1141 | 0.14
1 | PTC0603 | PTC0603 | 603 | F1 | PTC RESTTBLE 0.10A 15V CHIP 0603 | 507-1818-1-ND |  | Bel Fuse Inc | 0ZCM0010FF2G | 0.14 | 0.107 | 0.107 | 0.14
1 | 10k | R603X42012 | 2012(4_RES) | R10 | RES ARRAY 10K OHM 4 RES 2012 | MNR34103CT-ND |  | Rohm Semiconductor | MNR34J5ABJ103 | 0.3 | 0.0984 | 0.0984 | 0.3
1 | 1MEG | R603X42012 | 2012(4_RES) | R9 | RES ARRAY 1M OHM 4 RES 2012 | MNR34105CT-ND |  | Rohm Semiconductor | MNR34J5ABJ105 | 0.3 | 0.094 | 0.094 | 0.3
1 | 2.2nH | LL0603 | L0603 | L6 | FIXED IND 2.2NH 500MA 90 MOHM | PCD1965CT-ND |  | Panasonic Electronic Components | ELJ-RE2N2DFA | 0.11 | 0.0872 | 0.0872 | 0.11
1 |  |  |  | RED | LED 1.6X0.8 470NM BL WTR RED SMD |  | 604-APT1608SRCPRV | Kingbright |  | 0.14 | 0.071 | 0.071 | 0.14
1 |  |  |  | YELLOW | LED 1.6X0.8 470NM BL WTR YLW SMD |  | 604-APT1608SYCK | Kingbright | APT1608SYCK | 0.15 | 0.071 | 0.071 | 0.15
1 | 2nF | C0603 | C0603 | C9 | CAP CER 2000PF 50V 5% NP0 0603 | 490-1458-1-ND |  | Murata Electronics North America | GRM1885C1H202JA01D | 0.13 | 0.0428 | 0.0428 | 0.13
1 | 470nF | C-EUC0603 | C0603 | C22 | CAP CER 0.47UF 50V 10% X5R 0603 | 587-3171-1-ND |  | Taiyo Yuden | UMK107ABJ474KA-T | 0.11 | 0.0381 | 0.0381 | 0.11
1 | 16pF | C0402 | C0402 | C35 | CAP CER 16PF 50V 5% NP0 0402 | 399-8829-1-ND |  | Kemet | CBR04C160F5GAC | 0.34 | 0.1412 | 0.1412 | 0.34
1 | 10k | R-US_R0603 | R0603 | R4 | RES 10K OHM 1/10W 1% 0603 | RMCF0603FT10K0CT-ND |  | Stackpole Electronics Inc | RMCF0603FT10K0 | 0.1 | 0.0105 | 0.0105 | 0.1
1 | 47k | R-US_R0603 | R0603 | R1 | RES 47K OHM 1/10W 1% 0603 | RMCF0603FT47K0CT-ND |  | Stackpole Electronics Inc | RMCF0603FT47K0 | 0.1 | 0.0105 | 0.0105 | 0.1
1 | 56k | R-US_R0603 | R0603 | R3 | RES 56K OHM 1/10W 1% 0603 | RMCF0603FT56K0CT-ND |  |  | RMCF0603FT56K0 | 0.1 | 0.0105 | 0.0105 | 0.1
1 | 0 | R-US_R0603 | R0603 | R6 | RES 0.0 OHM 1/10W JUMP 0603 SMD | RHM0.0CGCT-ND |  | Rohm Semiconductor | MCR03ERTJ000 | 0.1 | 0.0042 | 0.0042 | 0.1
5 | DNI | C-EUC0603 | C0603 | C30, C31, C32, C33, C34 |  |  |  |  |  |  |  | 0 | 0
2 | DNI | R-US_R0603 | R0603 | R5, R7 |  |  |  |  |  |  |  | 0 | 0
1 | DNI | R603X42012 | 2012(4_RES) | R8 | Quad resistor package 0603 |  |  |  |  |  |  | 0 | 0
1 | DNP | LL0603 | L0603 | L9 |  |  |  |  |  |  |  | 0 | 0
1 | PCB_ANTENNA_915MHZOSHP | PCB_ANTENNA_915MHZOSHP | PCB_ANTENNA_915MHZ | U$7 |  |  |  |  |  |  |  | 0 | 0
0 | SWITCH-MOMENTARY-212MM | SWITCH-MOMENTARY-212MM | TACTILE-PTH-12MM | S1 | SWITCH TACTILE SPST-NO 0.05A 24V | SW412-ND |  | Omron Electronics Inc-EMC Div | B3F-4005 | 0.54 | 0.4253 | 0 | 0
0 | SWITCH-MOMENTARY-212MM | SWITCH-MOMENTARY-212MM | TACTILE-PTH-12MM | S2 | SWITCH TACTILE SPST-NO 0.05A 24V | SW411-ND |  | Omron Electronics Inc-EMC Div | B3F-4000 | 0.54 | 0.4253 | 0 | 0
0 | SWITCH-MOMENTARY-212MM | SWITCH-MOMENTARY-212MM | TACTILE-PTH-12MM | S3 | SWITCH TACTILE SPST-NO 0.05A 24V | SW800-ND |  | Omron Electronics Inc-EMC Div | B3F-5000 | 0.65 | 0.5108 | 0 | 0
0 | SWITCH-MOMENTARY-212MM | SWITCH-MOMENTARY-212MM | TACTILE-PTH-12MM | S4 | SWITCH TACTILE SPST-NO 0.05A 12V | CKN9139-ND |  | C&K Components | PTS125SK43 LFS | 0.44 | 0.3432 | 0 | 0
3 | TEST-POINT3 | TEST-POINT3 | PAD.03X.03 | TP1, TP2, TP3 | Bare copper test points for troubleshooting or ICT |  |  |  |  |  |  | 0 | 0
4 | TOUCH-PAD | TOUCH-PAD | TOUCH-PAD | U$1, U$3, U$4, U$5 |  |  |  |  |  |  |  | 0 | 0
 |  |  |  |  |  |  |  |  |  |  |  | 0.6024 | 0
Total at 1x | 25.395 |  | 1% | 5% | 10%
Total at 100x | 10.1514 |  | 0.25395 | 1.26975 | 2.5395
