DroningOn/ECE411/BOM/MCU_Prices.xlsx

MCU | Price/unit - min @ 100 units | Price via Distrobuter | Qty Avail | Order Min
PIC16LF1824T39A | $1.61 | Microchip Direct | 2516 | 1
CC430F5133 | $3.57 | Rochester | 586 | 1
CC430F5135 | $3.71 | Rochester | 500 | 1
CC430F5137 | $2.96 | Vertical | 156 | 52
STM32W108HB | $5.00 | Digikey | 5981 | 1
