DroningOn/ECE411/WikiMaterials/classroomInteractiveDeviceGist.png

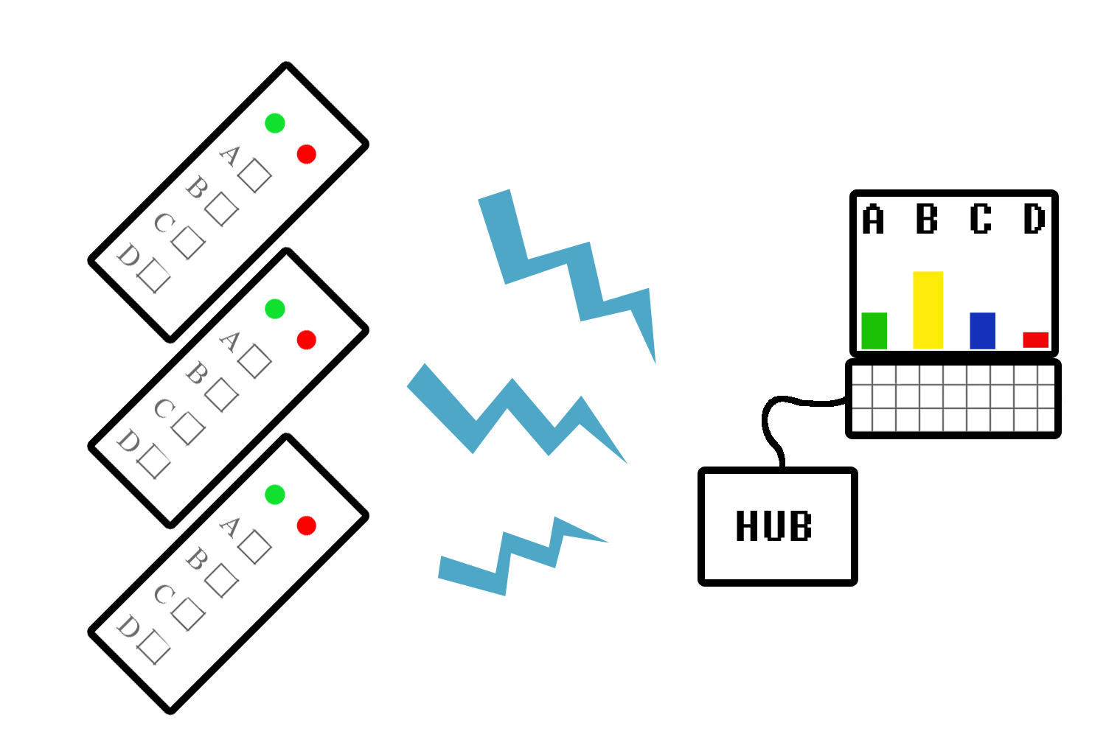
WikiMaterials/classroomInteractiveDeviceGist.png
