DroningOn/ECE411/WikiMaterials/HWDocuments/ECE411T08HW5/ECE411 HW#5 UML.png

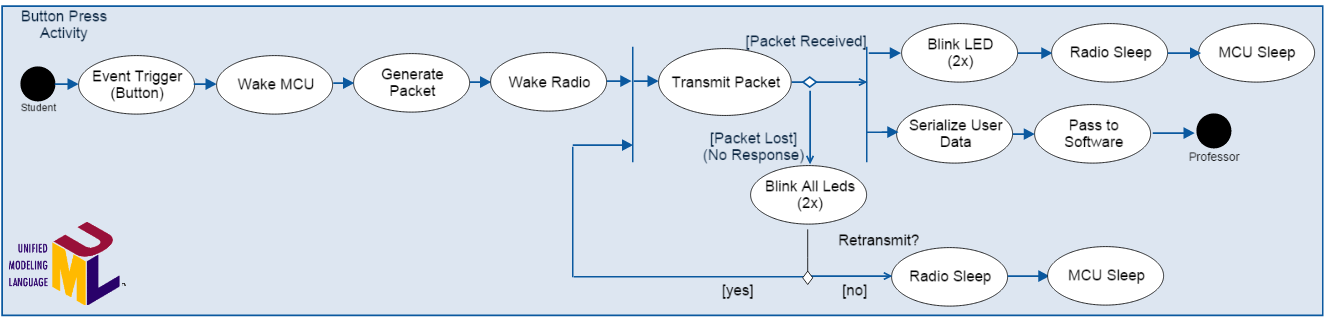
WikiMaterials/HWDocuments/ECE411T08HW5/ECE411 HW#5 UML.png
