DroningOn/ECE411/WikiMaterials/HWDocuments/ECE411T08HW5/ECE 411 HW5.png

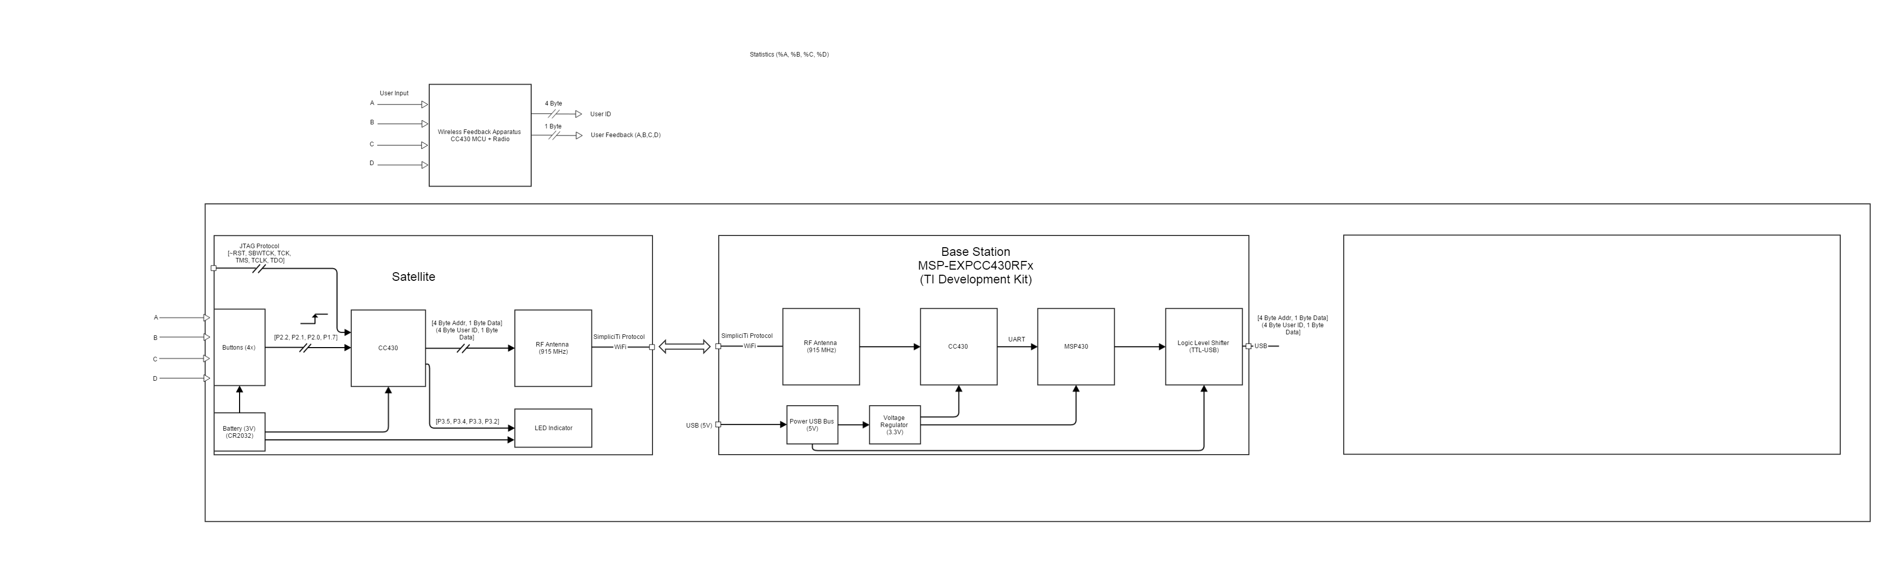
WikiMaterials/HWDocuments/ECE411T08HW5/ECE 411 HW5.png
