DroningOn/ECE411/WikiMaterials/HWDocuments/ECE411T08HW5/Level1Complete.PNG

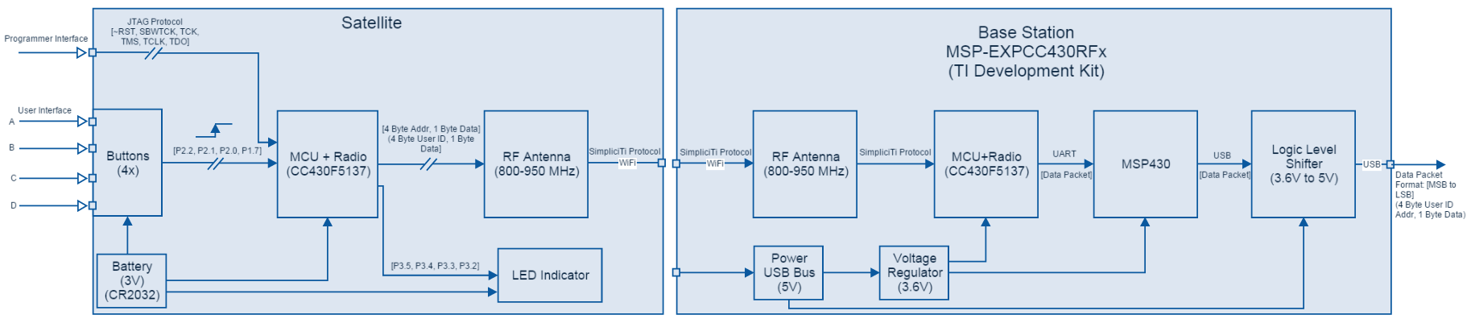
WikiMaterials/HWDocuments/ECE411T08HW5/Level1Complete.PNG
