DroningOn/ECE411/WikiMaterials/HWDocuments/ECE411T08HW6/Eagle Reference Docs/Top.PNG

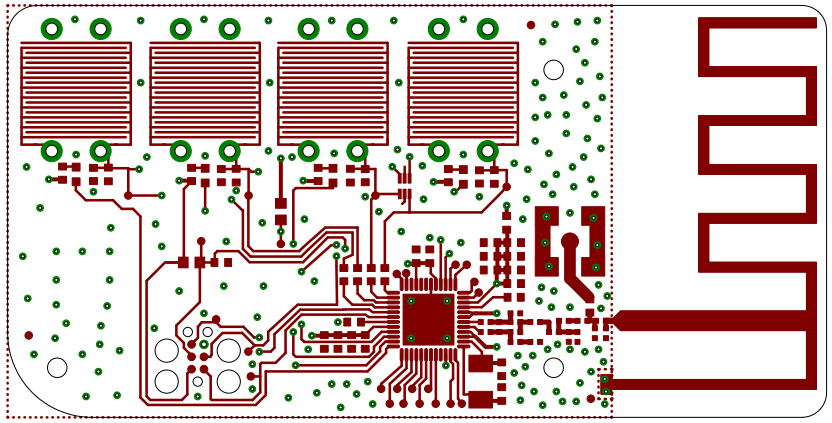
WikiMaterials/HWDocuments/ECE411T08HW6/Eagle Reference Docs/Top.PNG
