DroningOn/ECE411/WikiMaterials/T08-BoardLayout.png

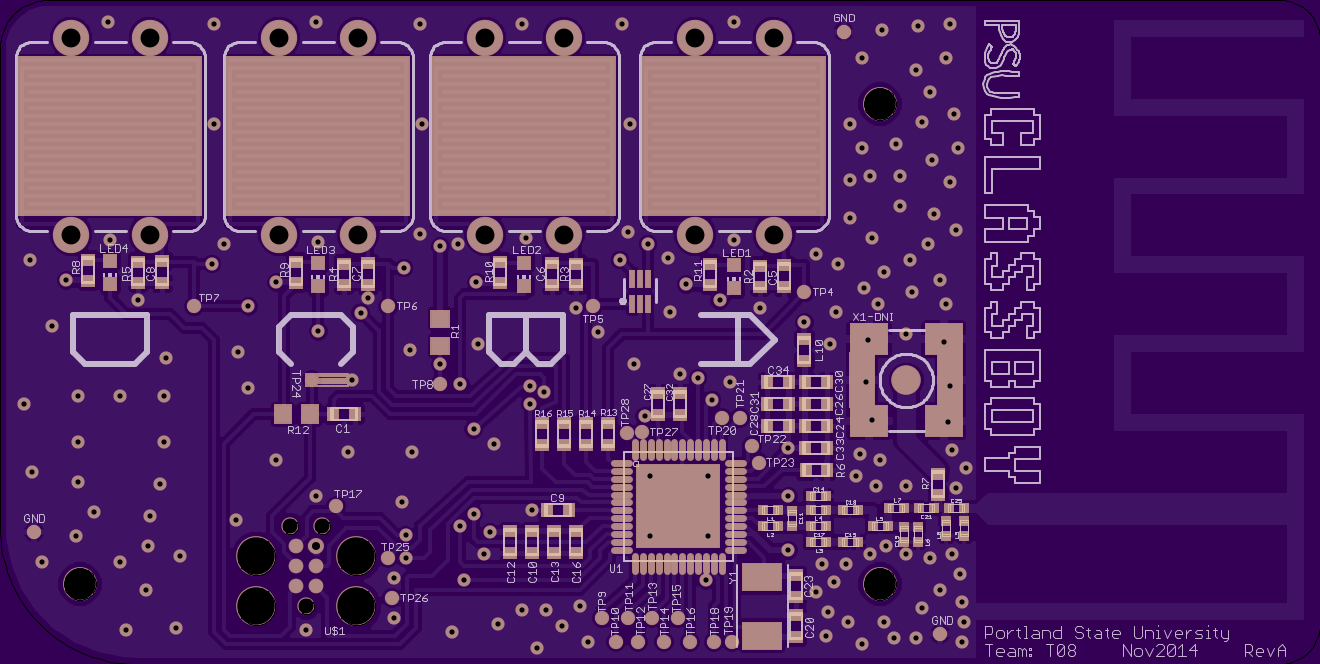
WikiMaterials/T08-BoardLayout.png
