DroningOn/ECE411/(list of files, cad)

Other CAD files:
Antenna_Design/ECE411Antenna_wrk/simulation/ECE411Antenna_lib/F_antLayout_1/layout/emSetup_MoM/proj.prt
Antenna_Design/ECE411Antenna_wrk/simulation/ECE411Antenna_lib/F_antLayout_1/layout/emSetup_viz3D/proj.prt
Antenna_Design/ECE411Antenna_wrk/simulation/ECE411Antenna_lib/antLayout_1/layout/_viz3D_viz3D/proj.prt
Antenna_Design/ECE411Antenna_wrk/simulation/ECE411Antenna_lib/antLayout_1/layout/emSetup_MoM/proj.prt
Antenna_Design/ECE411Antenna_wrk/simulation/ECE411Antenna_lib/antLayout_1/layout/emSetup_export2EMPro/proj.prt
Antenna_Design/ECE411Antenna_wrk/simulation/ECE411Antenna_lib/antLayout_1/layout/emSetup_viz3D/proj.prt
Antenna_Design/ECE411Antenna_wrk/simulation/ECE411Antenna_lib/antLayout_test/layout/emSetup_MoM/proj.prt
