DroningOn/ECE411/Testing/100 connections.docx

Test Writer: Matt Downey
Test Case Name: | | 100 users connections | | | | Test ID #:
Description: | | Modified Satellite code to create 100 unique IDs to be linked to base | | | | Type: | White Box Black Box

Tester Information:
Name of Tester: | | Chris Halseth | | | | Date: | 12/11/2014
Software Version: | | A | | | | Time: | 8:45pm
Setup: | | Ensure base station is loaded with Rev A and powered up. Load satellite with address cycle code.
Step | Action | Expected Result | Pass | Fail | Comments
1 | Power up satellite | Blue and green LED's alternate.
2 | Read device counter on base after all LED's light. | Device counter reads 100.
