DroningOn/ECE411/Testing/Distance Test.docx

Test Writer: Matt Downey
Test Case Name: | | Distance test | | | | Test ID #:
Description: | | Test connection distance | | | | Type: | White Box Black Box

Tester Information:
Name of Tester: | | Matt Downey / Michael Schmidt | | | | Date:
Hardware Version: | | | | | | Time:
Setup: | | Travel to football field. Turn on Base Station
Step | Action | Expected Result | Pass | Fail | Comments
1 | Distancing | Michael to stand at 0 yard line with base station & Matt to walk to 50 yard line
2 | Button Press | Matt to Press button and verify input LED blinked twice
