DroningOn/ECE411/WikiMaterials/HWDocuments/ECE411T08HW6/CurrentSenseTest.PNG

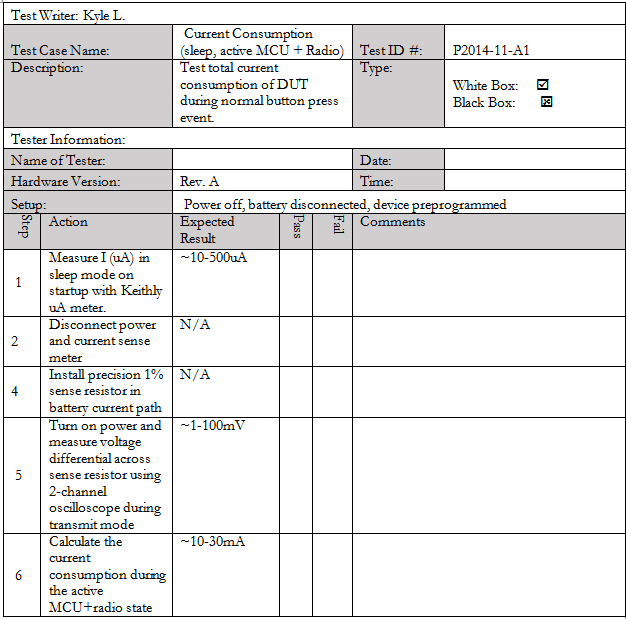
WikiMaterials/HWDocuments/ECE411T08HW6/CurrentSenseTest.PNG
