DroningOn/ECE411/Antenna_Design/ECE411Antenna_wrk/SParameters_MatchedAntenna.pdf

# S-Parameters vs. Frequency

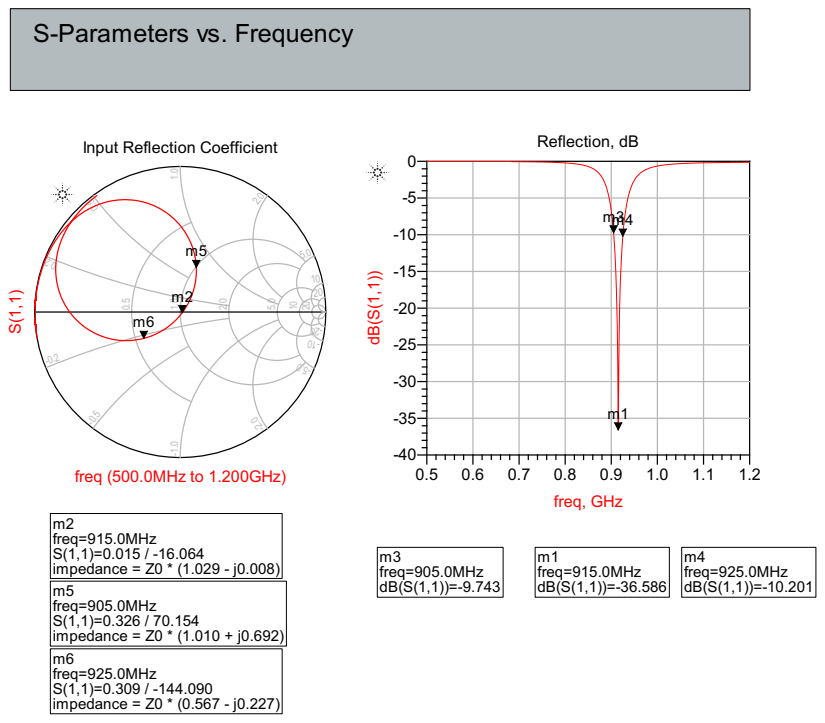
[picture p47: page 1]
freq (500.0MHz to 1.200GHz); m2 freq= S(1,1)=0.015 / -16.064; impedance = Z0 * (1.029 - j0.008); 915.0MHz; m5 freq= S(1,1)=0.326 / 70.154; impedance = Z0 * (1.010 + j0.692); 905.0MHz; m6 freq= S(1,1)=0.309 / -144.090; impedance = Z0 * (0.567 - j0.227); 925.0MHz; freq, GHz; Reflection, dB; m1 freq= dB(S(1,1))=-36.586; m3 freq= dB(S(1,1))=-9.743; m4 freq= dB(S(1,1))=-10.201

Input Reflection Coefficient
