DroningOn/ECE411/Eagle/Schematics & Board Layout/Tx Board Schematic/T08-TxClicker-Rev1a/T08-TxClicker-Rev1a.pdf

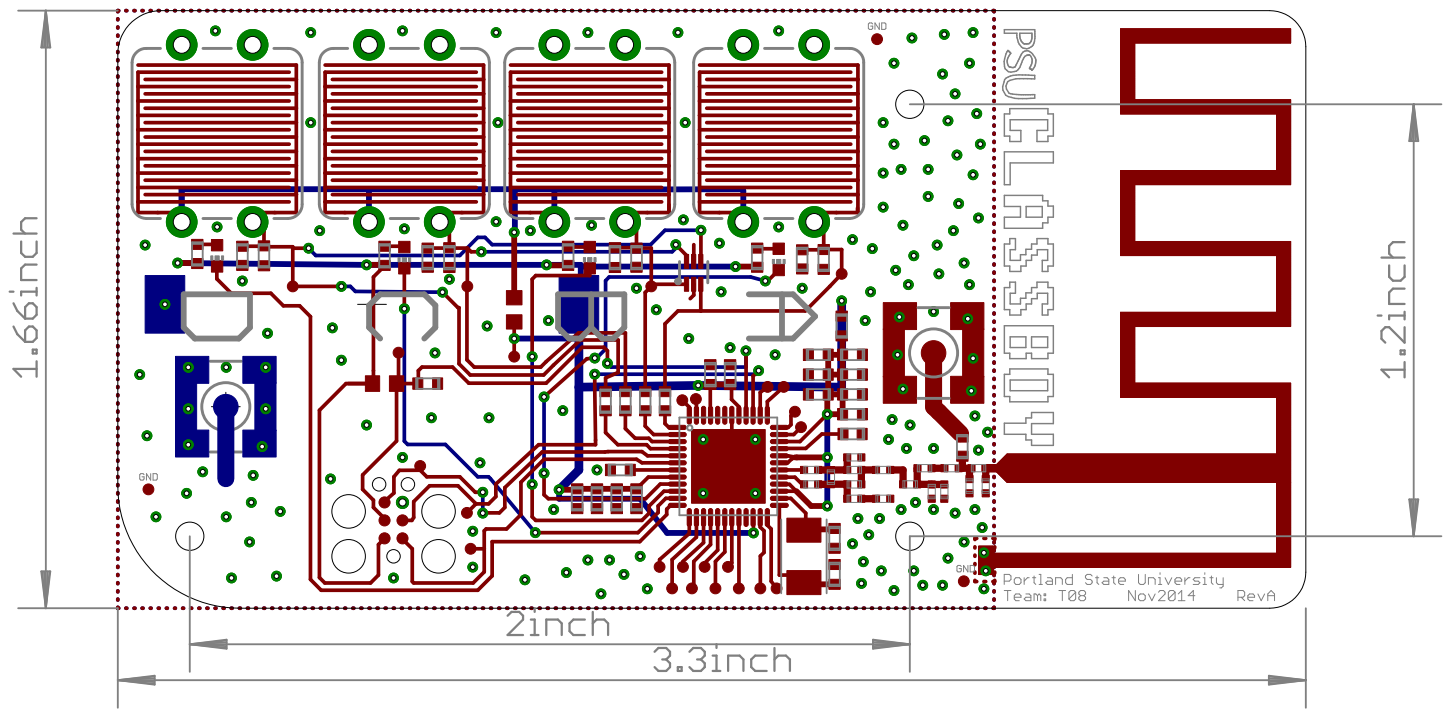
[picture p48: page 1]
