DroningOn/ECE411/WikiMaterials/HWDocuments/ECE411T08HW6/Eagle Reference Docs/T08-TxClicker-Rev1a-All.pdf

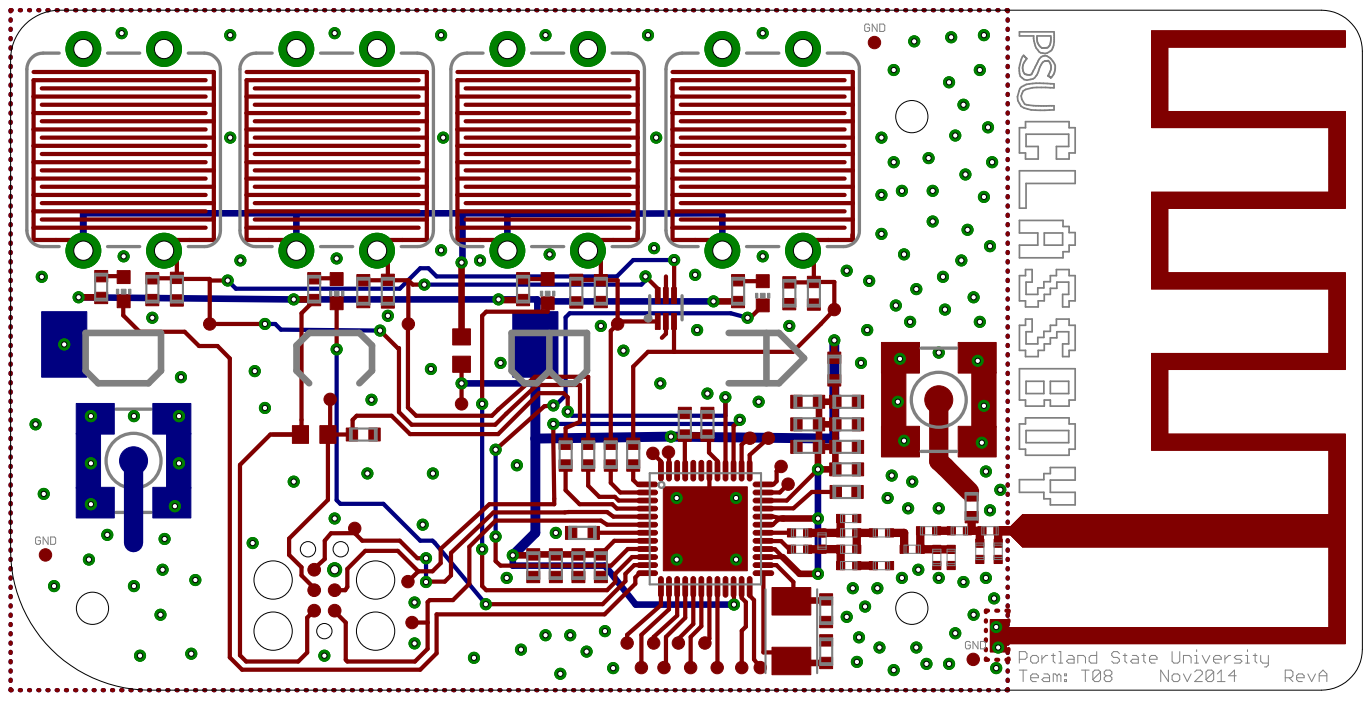
[picture p49: page 1]
