DroningOn/ECE411/WikiMaterials/HWDocuments/ECE411T08HW6/Eagle Reference Docs/T08-TxClicker-Rev1a-bot.pdf

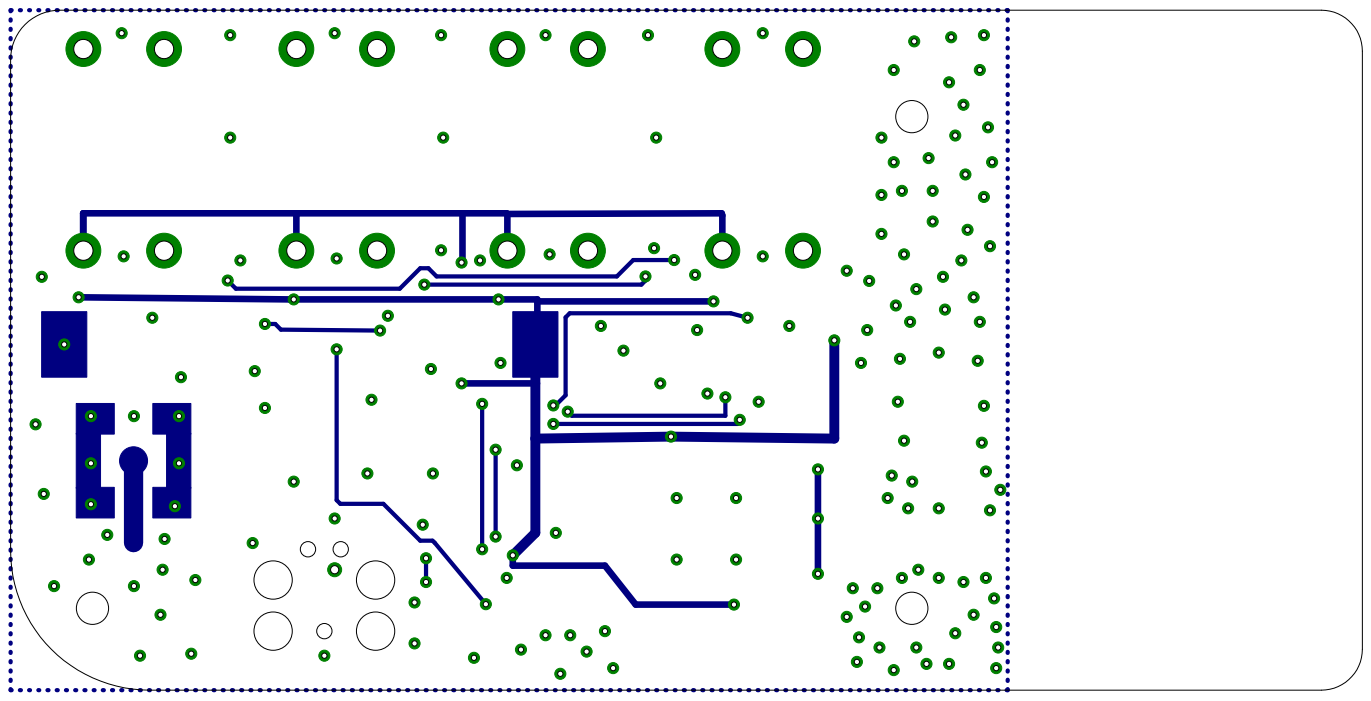
[picture p50: page 1]
