DroningOn/ECE411/WikiMaterials/HWDocuments/ECE411T08HW6/Eagle Reference Docs/T08-TxClicker-Rev1a-ComponentOutline.pdf

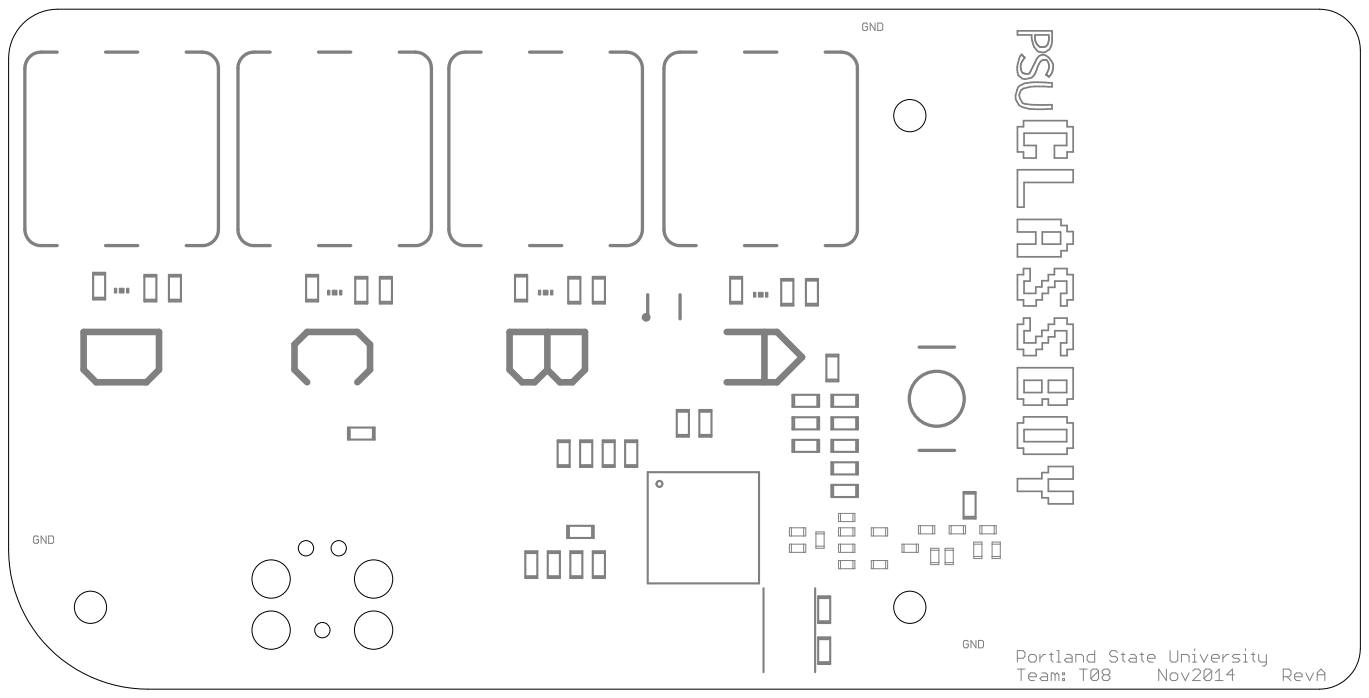
[picture p51: page 1]
