DroningOn/ECE411/Eagle/Schematics & Board Layout/Tx Board Schematic/T08-TxClicker-Rev1a/T08-TxClicker-Rev1a.brd

## EAGLE design Eagle/Schematics & Board Layout/Tx Board Schematic/T08-TxClicker-Rev1a/T08-TxClicker-Rev1a.brd (2014-12-12)

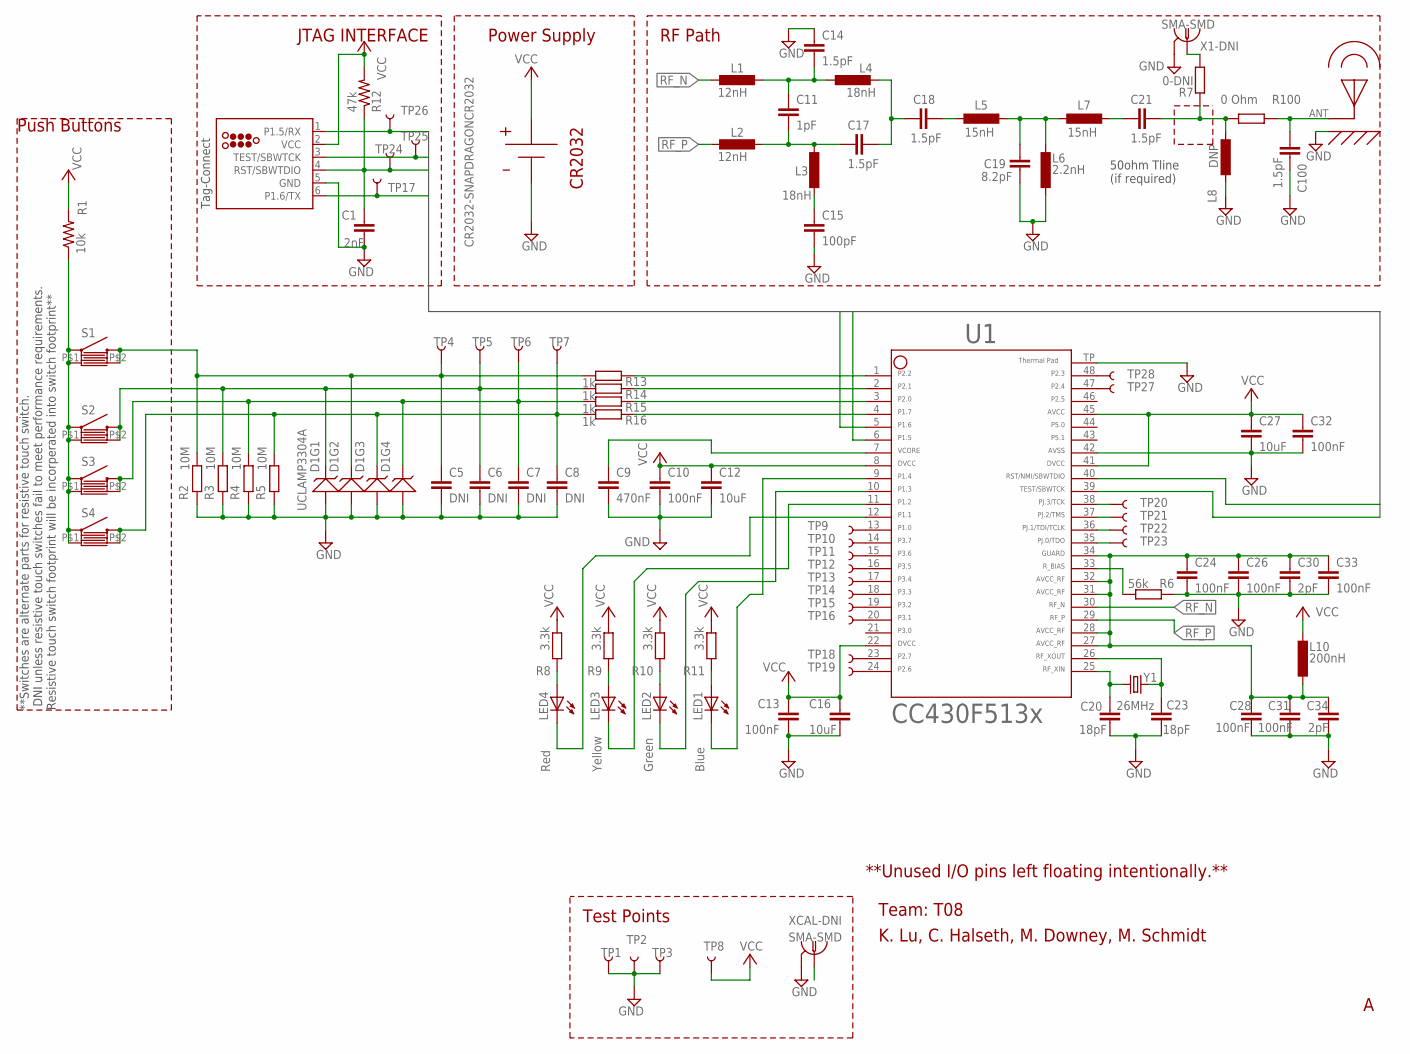
[picture p55: schematic T08-TxClicker-Rev1a.sch]

Parts:
C1: 2nF; C0603
C5, C6, C7, C8: DNI; C0603
C9: 470nF; C0603
C10, C13, C24, C26, C28, C31, C32, C33: 100nF; C0603
C11: 1pF; C0402
C12, C16, C27: 10uF; C0603
C14, C17, C18, C21, C100: 1.5pF; C0402
C15: 100pF; C0402
C19: 8.2pF; C0402
C20, C23: 18pF; C0603
C30, C34: 2pF; C0603
D1: UCLAMP3304A; SOT666
L1, L2: 12nH; L0402
L3, L4: 18nH; L0402
L5, L7: 15nH; L0402
L6: 2.2nH; L0402
L8: DNP; L0402
L10: 200nH; L0603
LED1: Blue; CHIP-LED0603
LED2: Green; CHIP-LED0603
LED3: Yellow; CHIP-LED0603
LED4: Red; CHIP-LED0603
R1: 10k; R0603
R2, R3, R4, R5: 10M; R0603
R6: 56k; R0603
R7: 0-DNI; R0603
R8, R9, R10, R11: 3.3k; R0603
R12: 47k; R0603
R13, R14, R15, R16: 1k; R0603
R100: 0 Ohm; R0402
S1, S2, S3, S4: TOUCHPAD_SWITCH_COMBOSWITC_TOUCHPAD; TACTILE-PTH-12MM
TP1, TP2, TP3, TP4, TP5, TP6, TP7, TP8, TP10, TP11, TP12, TP13, TP14, TP15, TP16, TP17, TP18, TP19, TP20, TP21, TP22, TP23, TP24, TP25, TP26, TP27, TP28: TEST-POINT3; PAD.03X.03
TP9: TP9; PAD.03X.03
U1: CC430F513X---RGZ48; RGZ48
U$1: TC2030-MCP
U$5: CR2032-SNAPDRAGONCR2032; CR2032-SNAPDRAGON
U$6: PCB_ANTENNA_915MHZOSHP; PCB_ANTENNA_915MHZ
X1-DNI: SMA-SMD
XCAL-DNI: SMA-SMD
Y1: 26MHz; CRYSTAL-TXC-7A

Connections:
ANTENNA: C100.P$2 (2), R100.P$1 (1), U$6.ANT
GND: C1.2, C5.2, C6.2, C7.2, C8.2, C9.2, C10.2, C12.2, C13.2, C14.P$1 (1), C15.P$2 (2), C16.2, C19.P$1 (1), C20.2, C23.2, C24.2, C26.2, C27.2, C28.2, C30.2, C31.2, C32.2, C33.2, C34.2, C100.P$1 (1), D1.2, D1.5 (2), L6.P$2 (2), L8.P$1 (1), R2.1, R3.1, R4.1, R5.1, R6.1, TP1.P$1, TP2.P$1, TP3.P$1, U1.42, U1.TP (49), U$1.5 (GND), U$5.V-, U$6.GPLANE (GND), X1-DNI.2@1 (2), X1-DNI.2@2 (2), X1-DNI.2@3 (2), X1-DNI.2@4 (2), X1-DNI.2@5 (2), X1-DNI.2@6 (2), XCAL-DNI.2@1 (2), XCAL-DNI.2@2 (2), XCAL-DNI.2@3 (2), XCAL-DNI.2@4 (2), XCAL-DNI.2@5 (2), XCAL-DNI.2@6 (2)
unnamed: C11.P$2 (2), C17.P$2 (2), L2.P$1 (1), L3.P$1 (1)
unnamed: C11.P$1 (1), C14.P$2 (2), L1.P$1 (1), L4.P$2 (2)
unnamed: C17.P$1 (1), C18.P$1 (1), L4.P$1 (1)
unnamed: C15.P$1 (1), L3.P$2 (2)
unnamed: C18.P$2 (2), L5.P$1 (1)
unnamed: C19.P$2 (2), L5.P$2 (2), L6.P$1 (1), L7.P$1 (1)
unnamed: R16.2, U1.4
unnamed: C21.P$2 (2), L7.P$2 (2)
unnamed: R15.2, U1.3
unnamed: LED2.C, U1.10
unnamed: R1.1, S1.1 (BASE), S1.P$1 (BASE), S2.1 (BASE), S2.P$1 (BASE), S3.1 (BASE), S3.P$1 (BASE), S4.1 (BASE), S4.P$1 (BASE)
unnamed: C21.P$1 (1), L8.P$2 (2), R7.1, R100.P$2 (2)
unnamed: LED4.A, R8.1
unnamed: LED3.A, R9.1
unnamed: LED3.C, U1.11
unnamed: LED2.A, R10.1
unnamed: LED1.A, R11.1
unnamed: LED4.C, U1.12
unnamed: R14.2, U1.2
unnamed: R13.2, U1.1
unnamed: TP13.P$1, U1.17
unnamed: TP9.P$1, U1.13
unnamed: TP10.P$1, U1.14
unnamed: TP11.P$1, U1.15
unnamed: TP12.P$1, U1.16
unnamed: TP14.P$1, U1.18
unnamed: TP15.P$1, U1.19
unnamed: TP16.P$1, U1.20
unnamed: TP18.P$1, U1.23
unnamed: TP19.P$1, U1.24
unnamed: TP27.P$1, U1.47
unnamed: TP28.P$1, U1.48
P1.4: LED1.C, U1.9
P1.5/RX: TP26.P$1, U1.6, U$1.1 (P1.5/RX)
P1.6/TX: TP17.P$1, U1.5, U$1.6 (P1.6/TX)
P1.7: C8.1, D1.4, R5.2, R16.1, S4.3 (TOP), S4.P$2 (TOP), TP7.P$1
P2.0: C7.1, D1.6, R4.2, R15.1, S3.3 (TOP), S3.P$2 (TOP), TP6.P$1
P2.1: C6.1, D1.1, R3.2, R14.1, S2.3 (TOP), S2.P$2 (TOP), TP5.P$1
P2.2: C5.1, D1.3 (1), R2.2, R13.1, S1.3 (TOP), S1.P$2 (TOP), TP4.P$1
PJ.0/TDO: TP23.P$1, U1.35
PJ.1/TDI/TCLK: TP22.P$1, U1.36
PJ.2/TMS: TP21.P$1, U1.37
PJ.3/TCK: TP20.P$1, U1.38
RF_N: L1.P$2 (2), U1.30
RF_P: L2.P$2 (2), U1.29
RF_PWR: C24.1, C26.1, C28.1, C30.1, C31.1, C33.1, C34.1, L10.2, U1.27, U1.28, U1.31, U1.32, U1.34
RF_TEST_50OHM: R7.2, X1-DNI.1
RF_XIN: C20.1, U1.25, Y1.P$1 (1)
RF_XOUT: C23.1, U1.26, Y1.P$2 (2)
RST/NMI/SBWTDIO: C1.1, R12.1, TP24.P$1, U1.40, U$1.4 (RST/SBWTDIO)
R_BIAS: R6.2, U1.33
TEST50: XCAL-DNI.1
TEST/SBWTCK: TP25.P$1, U1.39, U$1.3 (TEST/SBWTCK)
VCC: C10.1, C12.1, C13.1, C16.1, C27.1, C32.1, L10.1, R1.2, R8.2, R9.2, R10.2, R11.2, R12.2, TP8.P$1, U1.8, U1.22, U1.41, U1.45, U$1.2 (VCC), U$5.V+
VCORE: C9.1, U1.7

Notes on the sheet:
CR2032
RF Path
JTAG INTERFACE
K. Lu, C. Halseth, M. Downey, M. Schmidt
Team: T08
Push Buttons
**Unused I/O pins left floating intentionally.**
Test Points
50ohm Tline (if required)
Power Supply
Tag-Connect
**Switches are alternate parts for resistive touch switch. DNI unless resistive touch switches fail to meet performance requirements. Resistive touch switch footprint will be incorperated into switch footprint**

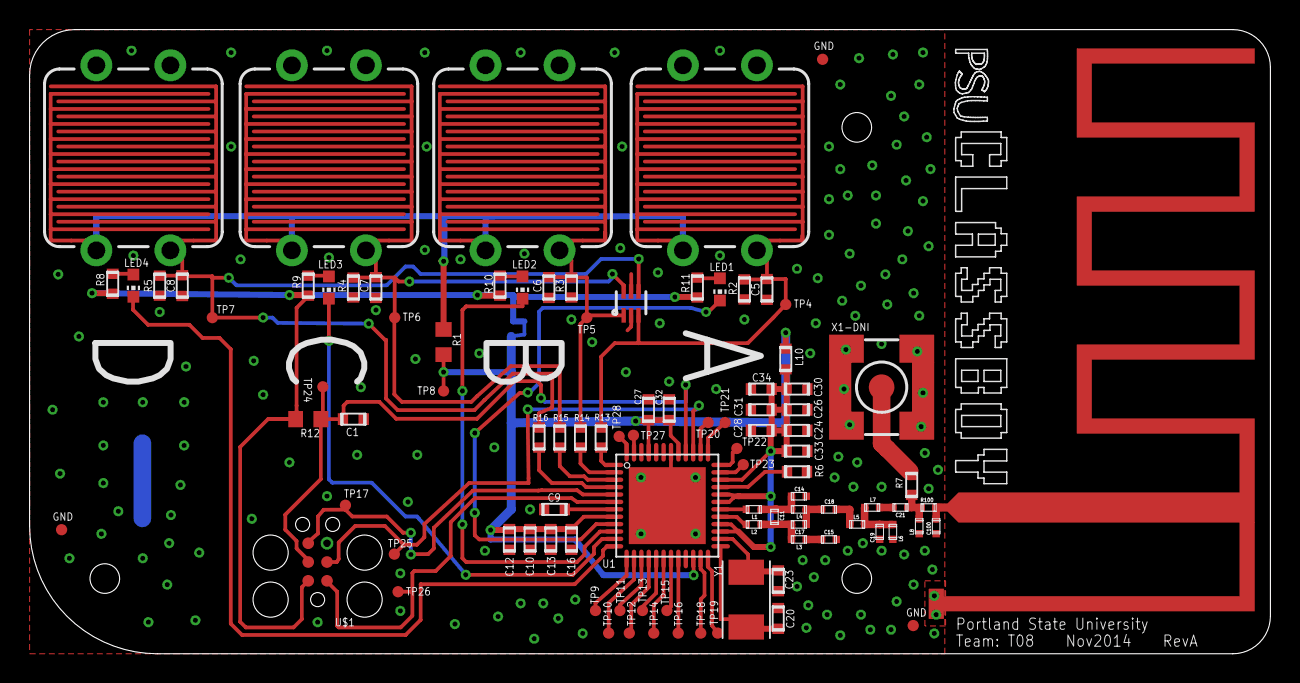
[picture p56: board T08-TxClicker-Rev1a.brd from above]

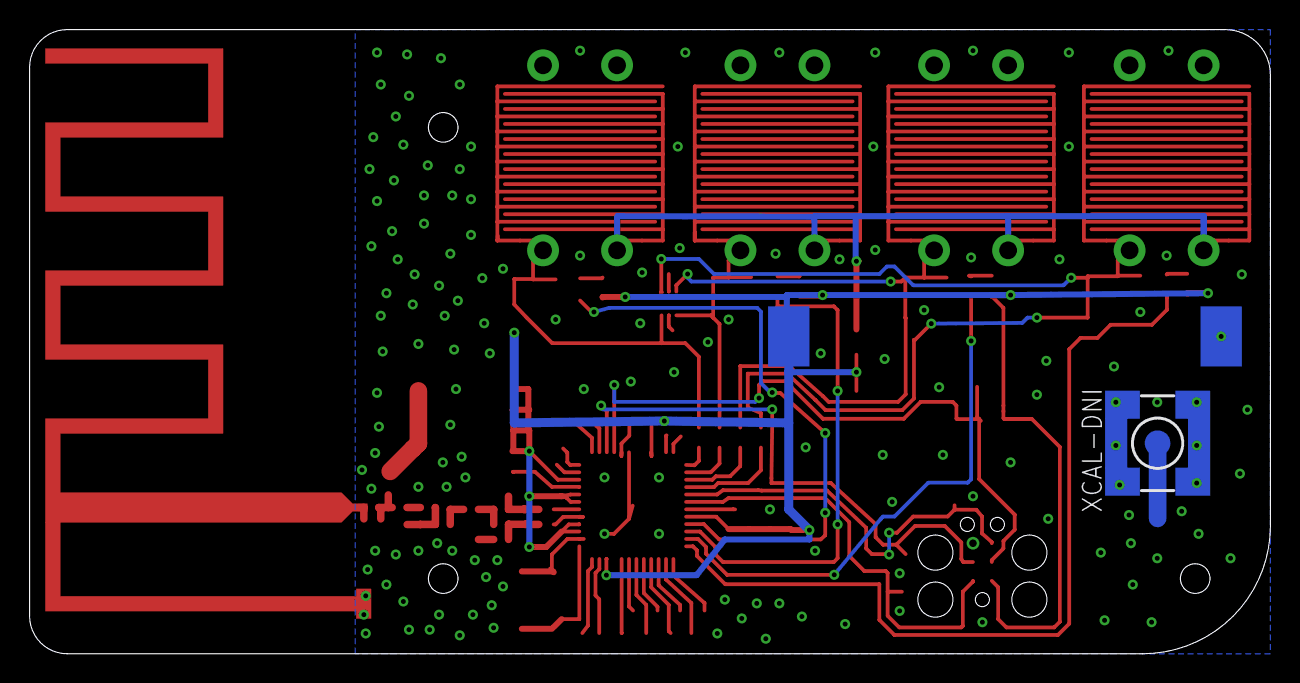
[picture p57: board T08-TxClicker-Rev1a.brd from below]

Board: 2 copper layers, 83.8 x 42.2 mm, 99 parts (2 on the bottom side), 56 nets.
