DroningOn/ECE411/Eagle/Schematics & Board Layout/Tx Board Schematic/T08-TxClicker-Rev0/T08-TxClicker.brd

## EAGLE design Eagle/Schematics & Board Layout/Tx Board Schematic/T08-TxClicker-Rev0/T08-TxClicker.brd (2014-11-05)

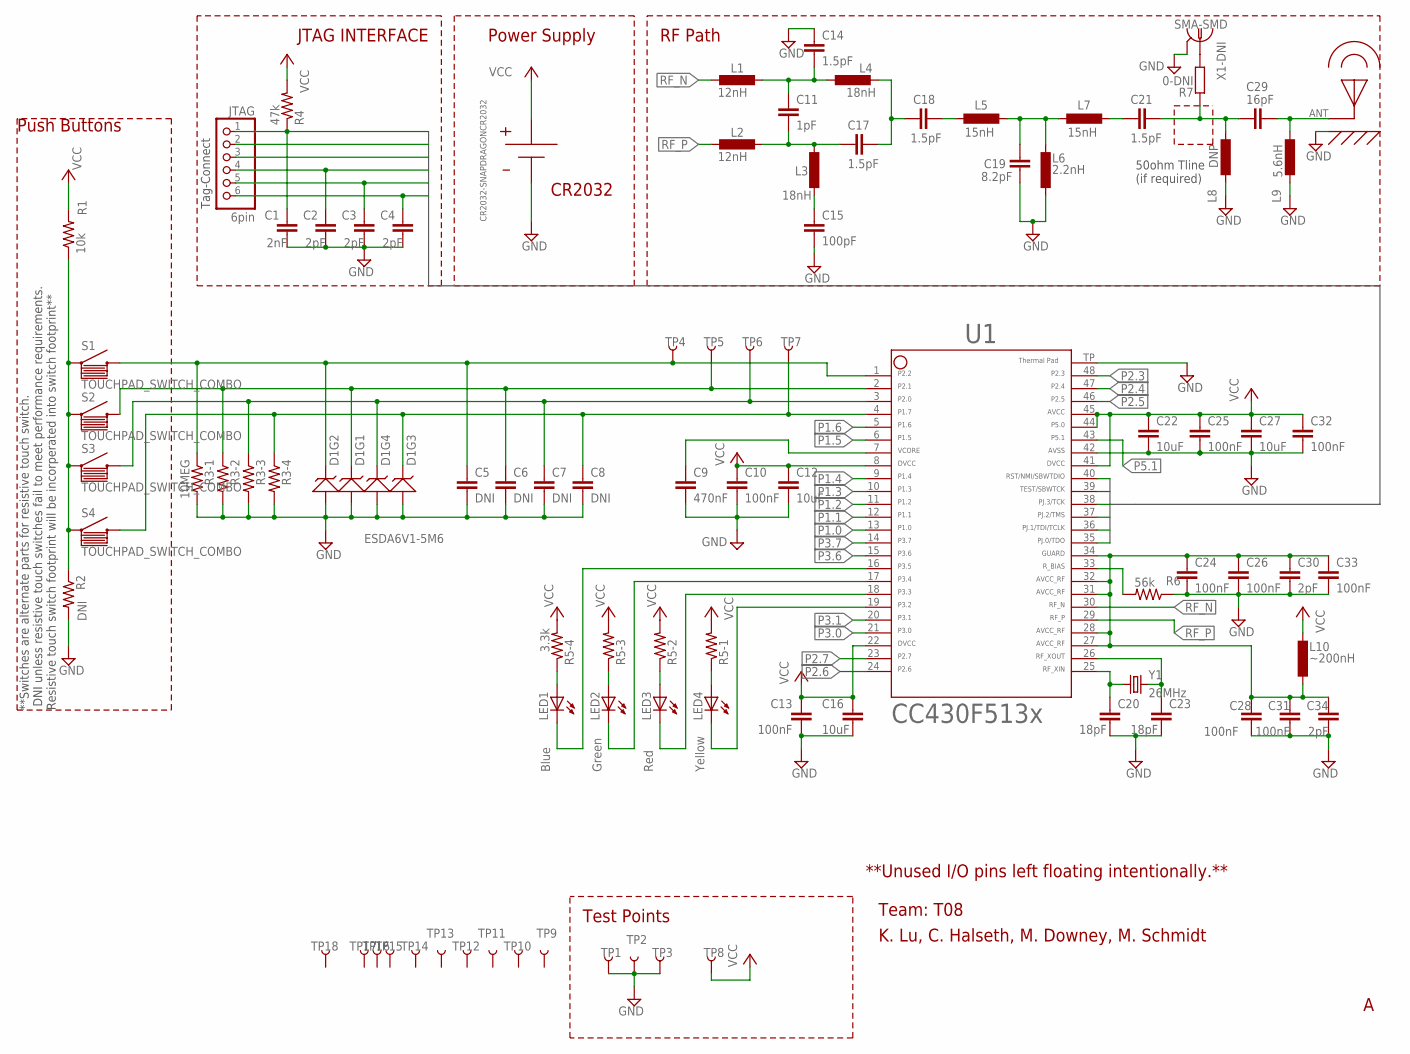
[picture p58: schematic T08-TxClicker.sch]

Parts:
C1: 2nF; C0603
C2, C3, C4, C30, C34: 2pF; C0603
C5, C6, C7, C8: DNI; C0603
C9: 470nF; C0603
C10, C13, C24, C25, C26, C28, C31, C32, C33: 100nF; C0603
C11: 1pF; C0402
C12, C16, C22, C27: 10uF; C0805
C14, C17, C18, C21: 1.5pF; C0402
C15: 100pF; C0402
C19: 8.2pF; C0402
C20, C23: 18pF; C0402
C29: 16pF; C0402
D1: ESDA6V1-5M6; 5X-TVS
JTAG: 6pin; 1X06
L1, L2: 12nH; L0402
L3, L4: 18nH; L0402
L5, L7: 15nH; L0402
L6: 2.2nH; L0402
L8: DNP; L0402
L9: 5.6nH; L0402
L10: ~200nH; L0603
LED1: Blue; CHIP-LED0603
LED2: Green; CHIP-LED0603
LED3: Red; CHIP-LED0603
LED4: Yellow; CHIP-LED0603
R1: 10k; R0603
R2: DNI; R0603
R3: 10MEG; 2012(4_RES)
R4: 47k; R0603
R5: 3.3k; 2012(4_RES)
R6: 56k; R0603
R7: 0-DNI; R0603
S1, S2, S3, S4: TOUCHPAD_SWITCH_COMBO; TACTILE-PTH-12MM
TP1, TP2, TP3, TP4, TP5, TP6, TP7, TP8, TP9, TP10, TP11, TP12, TP13, TP14, TP15, TP16, TP17, TP18: TEST-POINT3; PAD.03X.03
U1: CC430F513X---RGZ48; RGZ48
U$5: CR2032-SNAPDRAGONCR2032; CR2032-SNAPDRAGON
U$6: PCB_ANTENNA_915MHZOSHP; PCB_ANTENNA_915MHZ
X1-DNI: SMA-SMD
Y1: 26MHz; CRYSTAL-TXC-7A

Connections:
ANTENNA: C29.P$1 (1), L9.P$2 (2), U$6.ANT
GND: C1.2, C2.2, C3.2, C4.2, C5.2, C6.2, C7.2, C8.2, C9.2, C10.2, C12.2, C13.2, C14.P$1 (1), C15.P$2 (2), C16.2, C19.P$1 (1), C20.2, C22.2, C23.2, C24.2, C25.2, C26.2, C27.2, C28.2, C30.2, C31.2, C32.2, C33.2, C34.2, D1.2, L6.P$2 (2), L8.P$1 (1), L9.P$1 (1), R2.2, R3.2, R3.4 (2), R3.6 (2), R3.8 (2), R6.1, TP1.P$1, TP2.P$1, TP3.P$1, U1.42, U1.TP (49), U$5.V-, U$6.GPLANE, X1-DNI.2@1 (2), X1-DNI.2@2 (2), X1-DNI.2@3 (2), X1-DNI.2@4 (2), X1-DNI.2@5 (2), X1-DNI.2@6 (2)
unnamed: C11.P$2 (2), C17.P$2 (2), L2.P$1 (1), L3.P$1 (1)
unnamed: C11.P$1 (1), C14.P$2 (2), L1.P$1 (1), L4.P$2 (2)
unnamed: C17.P$1 (1), C18.P$1 (1), L4.P$1 (1)
unnamed: C15.P$1 (1), L3.P$2 (2)
unnamed: C18.P$2 (2), L5.P$1 (1)
unnamed: C19.P$2 (2), L5.P$2 (2), L6.P$1 (1), L7.P$1 (1)
unnamed: C21.P$2 (2), L7.P$2 (2)
unnamed: C24.1, C26.1, C28.1, C30.1, C31.1, C33.1, C34.1, L10.2, U1.27, U1.28, U1.31, U1.32, U1.34
unnamed: R7.2, X1-DNI.1
unnamed: R1.1, R2.1, S1.1, S2.1, S3.1, S4.1
unnamed: C21.P$1 (1), C29.P$2 (2), L8.P$2 (2), R7.1
unnamed: LED1.A, R5.7 (1)
unnamed: LED2.A, R5.5 (1)
unnamed: LED3.A, R5.3 (1)
unnamed: LED4.A, R5.1
P1.0: U1.13
P1.1: U1.12
P1.2: U1.11
P1.3: U1.10
P1.4: U1.9
P1.5: U1.6
P1.6: U1.5
P1.7: C8.1, D1.4, R3.7 (1), S4.3 (2), TP7.P$1, U1.4
P2.0: C7.1, D1.5, R3.5 (1), S3.3 (2), TP6.P$1, U1.3
P2.1: C6.1, D1.1, R3.3 (1), S2.3 (2), TP5.P$1, U1.2
P2.2: C5.1, D1.3, R3.1, S1.3 (2), TP4.P$1, U1.1
P2.3: U1.48
P2.4: U1.47
P2.5: U1.46
P2.6: U1.24
P2.7: U1.23
P3.0: U1.21
P3.1: U1.20
P3.2: LED4.C, U1.19
P3.3: LED3.C, U1.18
P3.4: LED2.C, U1.17
P3.5: LED1.C, U1.16
P3.6: U1.15
P3.7: U1.14
P5.1: U1.43
PJ.0/TDO: C4.1, JTAG.6, U1.35
PJ.1/TDI/TCLK: C3.1, JTAG.5, U1.36
PJ.2/TMS: C2.1, JTAG.4, U1.37
PJ.3/TCK: JTAG.3, U1.38
RF_N: L1.P$2 (2), U1.30
RF_P: L2.P$2 (2), U1.29
RF_XIN: C20.1, U1.25, Y1.P$1 (1)
RF_XOUT: C23.1, U1.26, Y1.P$2 (2)
RST/NMI/SBWTDIO: C1.1, JTAG.1, R4.1, U1.40
R_BIAS: R6.2, U1.33
TEST/SBWTCK: JTAG.2, U1.39
VCC: C10.1, C12.1, C13.1, C16.1, C22.1, C25.1, C27.1, C32.1, L10.1, R1.2, R4.2, R5.2, R5.4 (2), R5.6 (2), R5.8 (2), TP8.P$1, U1.8, U1.22, U1.41, U1.44, U1.45, U$5.V+
VCORE: C9.1, U1.7

Notes on the sheet:
CR2032
RF Path
JTAG INTERFACE
K. Lu, C. Halseth, M. Downey, M. Schmidt
Team: T08
Push Buttons
**Unused I/O pins left floating intentionally.**
Test Points
50ohm Tline (if required)
Power Supply
Tag-Connect
**Switches are alternate parts for resistive touch switch. DNI unless resistive touch switches fail to meet performance requirements. Resistive touch switch footprint will be incorperated into switch footprint**

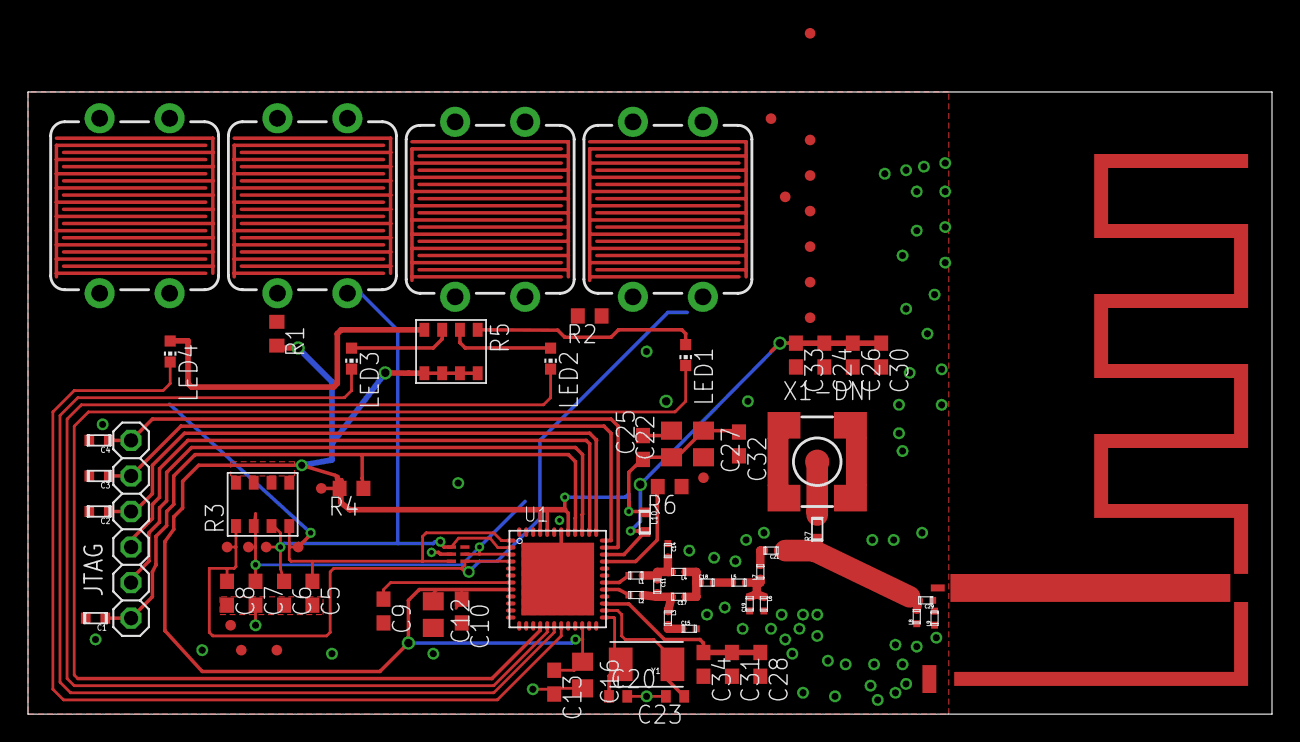
[picture p59: board T08-TxClicker.brd from above]

Board: 2 copper layers, 88.9 x 44.5 mm, 84 parts (1 on the bottom side), 38 nets.
