DroningOn/ECE411/Code/RevA/Base CC430F6137/Base.c

/*******************************************************************************
 *  Base.c - Core Application for the Base Station
 *  Revision A
 *  Portland State University ECE411 T08 Dec2014
 *
 *
 *  Overview: Application sets up and operates the base station as a hub in
 *  in a star network for receiving and processing incoming join network requests.
 *  Application has high level control over processing incoming packets from
 *  satellite devices and LCD display control. Incoming packets are repackaged
 *  and sent out via serial to the USB connected computer as they are recieved.
 *  After recieving join requests, incoming packets, or user button input
 *  (used to navigate the menus) the LCD is updated to show information relative
 *  to a current node structure containing information about number of connections
 *  to the hub, and information sent from the end devices such as last answer,
 *  battery level, and RSSI values.
 *
 *  Manages core behavior of PSU Classboy with high level control over:
 *
 *  	* Inputs
 *  	* Interrupt initialization
 *  	* Network management
 *      * LED Output
 *
 *  Inspiration for this application provided by:
 *  MspExp430F6137RxUserExperience - Main User Experience Application
 *  Copyright (C) 2010 Texas Instruments Incorporated - http://www.ti.com/
 *
 *******************************************************************************/

#include <string.h>
#include "bsp.h"
#include "mrfi.h"
#include "bsp_leds.h"
#include "bsp_buttons.h"
#include "nwk_types.h"
#include "nwk_api.h"
#include "nwk_frame.h"
#include "nwk.h"

#include "hal_leds.h"
#include "hal_buttons.h"
#include "hal_lcd.h"
#include "hal_adc.h"
#include "hal_uart.h"



/* reserve space for the maximum possible peer Link IDs */
static linkID_t sLID[NUM_CONNECTIONS];
static uint8_t  sNumCurrentPeers = 0;
/* callback handler */
static uint8_t sCB(linkID_t);
/* received message handler */
static void processMessage(linkID_t, uint8_t *, uint8_t, addr_t *);
/* work loop semaphores */
static volatile uint8_t sPeerFrameSem = 0;
static volatile uint8_t sJoinSem = 0;
/* blink LEDs when channel changes... */
static volatile uint8_t sBlinky = 0;

#define SPIN_ABOUT_A_QUARTER_SECOND   NWK_DELAY(250)

#define MESSAGE_LENGTH              6
#define SERIAL_LENGTH				5
#define ADDRESS_LENGTH				4

/*-----------------------------------------------------------------------------
 *  Currently defined transmission structure
 *
 *  Packet construct:
 *  Byte 0:   Content            button               User input
 *  Byte 1:   Content            Vcc                  Battery level
 *  Byte 2:   PacketID MSB                            Transmission counter highbyte
 *  Byte 3:   PacketID LSB                            Transmission counter lowbyte
 *
 *---------------------------------------------------------------------------- */
         
unsigned char string[6] = "xxxxxx";
unsigned char lastMessage = 0;

#define TEMP_MODE_FAHRENHEIT          0
#define TEMP_MODE_CELSIUS             1
unsigned char temperatureMode = TEMP_MODE_FAHRENHEIT;

#define UART_MODE_BRIEF               0
#define UART_MODE_VERBOSE             1
unsigned char uartMode = UART_MODE_VERBOSE;

#define NUM_CONNECTIONS 100

#define NODE_DISPLAY_ANSWER		        0
#define NODE_DISPLAY_RSSI               1
#define NODE_DISPLAY_SATCOUNT			2

#define NODE_PAGES						3


typedef struct _nodeInfo
{

  unsigned char address;
  signed char rssi;
  unsigned char answer;
  unsigned char vcc;
     
} nodeInfo;  


nodeInfo nodeInfos[NUM_CONNECTIONS];
unsigned char nodeNum = 1;                  // Node #0 = Access Point
unsigned char nodeCurrent = 0;              // Current node to display info on the LCD
unsigned char nodeInfoDisplayMode = NODE_DISPLAY_SATCOUNT;
unsigned char broadcastAlert = 0;
unsigned char lcdClearSymbol = 0; //Flag to clear symbols

 


void UpdateNodeInfoOnLcd(unsigned char nodeIndex);
unsigned char ConvertVccToLevel(unsigned char vcc);
void SetupRtc(void);



void Base (void)
{

  bspIState_t intState;
  unsigned char buttonsPressed;
  
     
  BSP_Init();
  HalButtonsInit(BUTTON_ALL);
  HalButtonsInterruptEnable(BUTTON_ALL);
  HalLedsInit(LED_ALL);
  HalLcdInit();
  HalUartInit();
  HalAdcInit();
  HalAdcSetQuitFromISR( 1 );
  
  nodeInfos[0].rssi = 0;
  nodeInfos[0].address = 0;
  
  __bis_SR_register(GIE);
  
  

   
  //memset(sSample, 0x0, sizeof(sSample));

  SMPL_Init(sCB);
  HAL_LEDS_SET(LED_1);
  /* green and red LEDs on solid to indicate waiting for a Join. */
  HalLcdPrint7SegScroll((unsigned char*)"Access Point Up", 15, LCD_SCROLL_REPEAT);
  SetupRtc();
  /* main work loop */
  while (1)
  {
    /* Wait for the Join semaphore to be set by the receipt of a Join frame from a
     * device that supports an End Device.
     *
     * An external method could be used as well. A button press could be connected
     * to an ISR and the ISR could set a semaphore that is checked by a function
     * call here, or a command shell running in support of a serial connection
     * could set a semaphore that is checked by a function call.
     */
    if (sJoinSem && (sNumCurrentPeers < NUM_CONNECTIONS))
    {
      /* listen for a new connection */
      HalLcdPrintStopScrolling();
      //HalLcdPrint7Seg((unsigned char*)"Listen");
      while (1)
      {
        HalLedsToggle(LED_1);
        if (SMPL_SUCCESS == SMPL_LinkListen(&sLID[sNumCurrentPeers]))
        {
          HalLedsSet(LED_2);
          HalLedsClear(LED_1);
          break;
        }
        /* Implement fail-to-link policy here. otherwise, listen again. */
      }
      //HalLcdPrint7SegScroll((unsigned char*)"Add End Device", 14, LCD_SCROLL_NO_REPEAT);
      HalLedsClear(LED_2);
      HalLedsSet(LED_3);
      nodeInfos[nodeNum].address = nodeNum;
      sNumCurrentPeers++;
      nodeNum++;
      BSP_ENTER_CRITICAL_SECTION(intState);
      sJoinSem--;
      BSP_EXIT_CRITICAL_SECTION(intState);
    }
   

    /* Have we received a frame on one of the ED connections?
     * No critical section -- it doesn't really matter much if we miss a poll
     */
    
    if (sPeerFrameSem)
    {
      uint8_t     msg[MAX_APP_PAYLOAD], len, i;
      addr_t sourceAddr[NET_ADDR_SIZE];

      /* process all frames waiting */
      for (i=0; i<sNumCurrentPeers; ++i)
      {
        if (SMPL_SUCCESS == SMPL_Receive(sLID[i], msg, &len, sourceAddr))
        {
          
          processMessage(sLID[i], msg, len, sourceAddr);
          BSP_ENTER_CRITICAL_SECTION(intState);
          sPeerFrameSem--;
          BSP_EXIT_CRITICAL_SECTION(intState);
        }
      }
    }

    buttonsPressed  = HalButtonsPressedIFG();
    if (buttonsPressed > 0)
    { 
      switch (buttonsPressed)
      {
        case BUTTON_U:  
                        if (nodeCurrent == 0)
                          nodeCurrent = nodeNum-1;
                        else
                          nodeCurrent--;     
                        if (nodeCurrent !=0)
                        {
                          if (nodeInfoDisplayMode == NODE_DISPLAY_SATCOUNT)
                            nodeInfoDisplayMode = NODE_DISPLAY_ANSWER;
                        }
                        else
                        {
                        	if (nodeInfoDisplayMode == NODE_DISPLAY_ANSWER)
                        	  nodeInfoDisplayMode = NODE_DISPLAY_SATCOUNT;
                        }
                        break;
                        
        case BUTTON_D:  
                        if (++nodeCurrent == nodeNum)
                          nodeCurrent = 0;
                        if (nodeCurrent !=0)
                        {
                        	if (nodeInfoDisplayMode == NODE_DISPLAY_SATCOUNT)
                        	  nodeInfoDisplayMode = NODE_DISPLAY_ANSWER;
                        }
                        else
                        {
                        	if (nodeInfoDisplayMode == NODE_DISPLAY_ANSWER)
                              nodeInfoDisplayMode = NODE_DISPLAY_SATCOUNT;
                        }
                        break;
                        
        case BUTTON_L:                    
        case BUTTON_R:
                        if (nodeCurrent != 0)   // Not Access Point                        
                        {
                        	if (buttonsPressed == BUTTON_L)
                        		nodeInfoDisplayMode += NODE_PAGES - 1;
                        	else
                        	    nodeInfoDisplayMode += 1;
                        	if (nodeInfoDisplayMode >=NODE_PAGES)
                        		nodeInfoDisplayMode -= NODE_PAGES;
                        	if(nodeInfoDisplayMode == NODE_DISPLAY_SATCOUNT) //Move one more if sat count on a satellite node
                        	{
                        		if (buttonsPressed == BUTTON_L)
                        			nodeInfoDisplayMode += NODE_PAGES - 1;
                        		else
                        			nodeInfoDisplayMode += 1;
                        		if (nodeInfoDisplayMode >=NODE_PAGES)
                        			nodeInfoDisplayMode -= NODE_PAGES;
                        	}

                        }  
                        else //Is Access Point
                        {
                          if (buttonsPressed == BUTTON_L)
                            nodeInfoDisplayMode += NODE_PAGES - 1;
                          else
                            nodeInfoDisplayMode += 1;
                          if (nodeInfoDisplayMode >=NODE_PAGES)
                            nodeInfoDisplayMode -= NODE_PAGES;
                          if(nodeInfoDisplayMode == NODE_DISPLAY_ANSWER) //Move one more
                          {
                        	  if (buttonsPressed == BUTTON_L)
                        		  	  nodeInfoDisplayMode += NODE_PAGES - 1;
                        	  else
                        		  	  nodeInfoDisplayMode += 1;
                        	  if (nodeInfoDisplayMode >=NODE_PAGES)
                        		  	  nodeInfoDisplayMode -= NODE_PAGES;
                          }

                        }

                        break;                      
        
      }
      UpdateNodeInfoOnLcd(nodeCurrent);
    }
    
    if (HalAdcJustUpdated())
    {
      HalAdcConvertTempVcc();
      nodeInfos[0].vcc = HalAdcGetVcc();

      if (!HalLcdIsScrolling())
        if (nodeCurrent == 0)
          UpdateNodeInfoOnLcd(0);
    }
    
    
    BSP_ENTER_CRITICAL_SECTION(intState);
    if (sBlinky)
    {
      if (++sBlinky >= 0xF)
      {
        sBlinky = 1;
        HalLedsToggle(LED_1 + LED_2);        
      }
    }
    BSP_EXIT_CRITICAL_SECTION(intState);
    
  }
  
}


/* Runs in ISR context. Reading the frame should be done in the */
/* application thread not in the ISR thread. */
static uint8_t sCB(linkID_t lid)
{
  if (lid)
  {
    sPeerFrameSem++;
    sBlinky = 0;
  }
  else
  {
    sJoinSem++;
  }

  /* leave frame to be read by application. */
  return 0;
}

static void processMessage(linkID_t lid, uint8_t *msg, uint8_t len, addr_t *sourceAddr)
{
  /* do something useful */
  ioctlRadioSiginfo_t sigInfo;
  if (len)
  {
	unsigned char outputString[SERIAL_LENGTH];
	char index;
    HalLedsToggle(LED_4);
    
    // Update rssi, answer, and battery level for the TXing Sat
    sigInfo.lid = lid;
    SMPL_Ioctl(IOCTL_OBJ_RADIO, IOCTL_ACT_RADIO_SIGINFO, (void *)&sigInfo);    
    nodeInfos[lid].rssi = sigInfo.sigInfo.rssi;
    nodeInfos[lid].answer = msg[0];
    nodeInfos[lid].vcc = msg[1];
    
    //Form serial message and send
    for(index = 0;index<ADDRESS_LENGTH; index++)
    {
    	outputString[index] = (*sourceAddr).addr[index];
    }
    outputString[SERIAL_LENGTH-1] = msg[0];
    HalUartTxString(outputString, sizeof outputString );
    UpdateNodeInfoOnLcd(nodeCurrent);
    
    //SetupRtc();
    *msg |= NWK_APP_REPLY_BIT;
    

  }
  return;
}



void UpdateNodeInfoOnLcd(unsigned char nodeIndex)
{
  HalLcdSetSymbolHeart();
  HalLcdBarBatteryMode();
  HalLcdBar (ConvertVccToLevel(nodeInfos[nodeIndex].vcc)) ;
  
  if (nodeIndex>0)
  {  
    //string[0] = '0'+(((nodeInfos[nodeIndex].address)/10)%10);
    string[0] = '0'+((nodeInfos[nodeIndex].address)/100%10);
    string[1] = '0'+((nodeInfos[nodeIndex].address)/10%10);
    string[2] = '0'+((nodeInfos[nodeIndex].address)%10);
  }
  else
  {
    string[0] = 'H';
    string[1] = ' ';
  
  }   
  
  if (nodeInfoDisplayMode == NODE_DISPLAY_SATCOUNT)
  {    
    
    string[2] = 'n';
    if (sNumCurrentPeers<1000)
    {
    	string[3] = '0'+((sNumCurrentPeers/100)%10);
    	string[4] = '0'+((sNumCurrentPeers/10)%10);
    	string[5] = '0'+((sNumCurrentPeers)%10);
      HalLcdPrint7Seg(string);

    }
    
  }
  else if (nodeInfoDisplayMode == NODE_DISPLAY_RSSI)   // NODE_DISPLAY_RSSI
  { 
    if (nodeInfos[nodeIndex].rssi == 0)
    {
      string[2]=' ';
      string[3]='H';
      string[4]='U';
      string[5]='B';  
    }

    else
    {

      string[3] = '-';
      string[4] = '0'+((-nodeInfos[nodeIndex].rssi/10)%10);
      string[5] = '0'+(-nodeInfos[nodeIndex].rssi%10);
      
    }
    HalLcdPrint7Seg(string);              
  }
  else                                      // NODE_DISPLAY_ANSWER
  {

      string[3] = ' ';
      string[4] = 'A' + nodeInfos[nodeIndex].answer;
      string[5] = ' ';
      HalLcdPrint7Seg(string);
  }
    
  lcdClearSymbol  = 1;
}

/**********************************************************************//**
 * @brief  Initializes the RTC module for interval mode 
 * 
 * 
 * 
 * @param  none 
 *  
 * @return none
 *************************************************************************/
void SetupRtc(void)
{  
  RTCCTL01 = RTCMODE + RTCBCD + RTCHOLD + RTCTEV_1;
  RTCCTL01 &= ~RTCHOLD;     
  RTCPS1CTL = RT1IP_5;              // Interrupt freq: 2Hz
  RTCPS1CTL |= RT1PSIE;
}





#pragma vector=RTC_VECTOR
__interrupt void RTC_ISR(void)
{
  static unsigned char updateAccessPointInfo = 0;
  switch (RTCIV)
  {
    default:      
      if (--lcdClearSymbol == 0)
      {        
        //HalLcdClearSymbolDegree();
        HalLcdClearSymbolBang();
        HalLcdClearSymbolHeart();          
      }
      if (HalLcdIsScrolling())
        HalLcdUpdateScrolling();
      if (++updateAccessPointInfo==4)
      {
        updateAccessPointInfo = 0;
        HalAdcStartRead();   
      }
      
  }
  
}


/**********************************************************************//**
 * @brief  Convert Vcc value into level for LCD's bar display 
 * 
 * Vcc range = 18 - 37
 * Bar range = 0  - 6
 * 
 * @param  none 
 *  
 * @return none
 *************************************************************************/
unsigned char ConvertVccToLevel(unsigned char vcc)
{
  unsigned char level = 0;
  while (vcc>=18)
  {
    vcc -= 3;
    level++;
  }
  if (level>6)
    level = 6;
  return level;
}
