DroningOn/ECE411/Code/RevA/Satellite CC430F5137/MSP-EXP430F5137_HAL/hal_buttons.c

/*******************************************************************************
 *
 *  hal_buttons.c - Hardware Abstraction Layer APIs for the buttons/port module
 *
 *  Copyright (C) 2010 Texas Instruments Incorporated - http://www.ti.com/
 *
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
 *    Redistributions of source code must retain the above copyright
 *    notice, this list of conditions and the following disclaimer.
 *
 *    Redistributions in binary form must reproduce the above copyright
 *    notice, this list of conditions and the following disclaimer in the
 *    documentation and/or other materials provided with the
 *    distribution.
 *
 *    Neither the name of Texas Instruments Incorporated nor the names of
 *    its contributors may be used to endorse or promote products derived
 *    from this software without specific prior written permission.
 *
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
 ******************************************************************************/

#include "msp430.h"
#include "hal_buttons.h"

unsigned char  buttonDebounce = 1;
volatile unsigned char  buttonsPressed = 0;
/**********************************************************************//**
 * @brief  Initializes the GPIO ports to act as buttons.
 * 
 * @param  buttonsMask The mask that specifies the button pins.
 * 
 * @return none
 *************************************************************************/   
void HalButtonsInit(unsigned char buttonsMask, unsigned char port)
{
	if(port == PORT1)
	{
		BUTTON_PORT1_OUT |= buttonsMask;
		BUTTON_PORT1_DIR &= ~buttonsMask;
		BUTTON_PORT1_REN &= ~buttonsMask;
		BUTTON_PORT1_SEL &= ~buttonsMask;
	}else if(port==PORT2)
	{
		BUTTON_PORT2_OUT |= buttonsMask;
		BUTTON_PORT2_DIR &= ~buttonsMask;
		BUTTON_PORT2_REN &= ~buttonsMask;
		BUTTON_PORT2_SEL &= ~buttonsMask;
	}
}

/**********************************************************************//**
 * @brief  Returns LOW for the buttons pressed.
 * 
 * @param  none
 * 
 * @return The buttons that have been pressed, identified by a bit = 0. 
 *************************************************************************/
unsigned char HalButtonsPressed(void)
{
  unsigned char value;
  value = BUTTON_PORT2_IN;
  return (0xFF - value);                    //Low==ButtonPressed
}

/**********************************************************************//**
 * @brief  Returns char (A,B,C,D) for the buttons pressed.
 *
 * @param  none
 *
 * @return The buttons that have been pressed, identified by a char (A,B,C,D).
 *************************************************************************/
unsigned char HalAlphaButtonsPressed(void)
{
  unsigned char port1Val = 0;
  unsigned char port2Val = 0;
  unsigned char button = 0;
  port1Val = BUTTON_PORT1_IN;
  port2Val = BUTTON_PORT2_IN;
  if((port2Val&BUTTON_A)==BUTTON_A) button = 0;
  if((port2Val&BUTTON_B)==BUTTON_B) button = 1;
  if((port2Val&BUTTON_C)==BUTTON_C) button = 2;
  if((port1Val&BUTTON_D)==BUTTON_D) button = 3;

  return button;                    //Low==ButtonPressed
}

/**********************************************************************//**
 * @brief  Returns HIGH for the buttons pressed registered by the interrupt.
 * 
 * @param  none
 * 
 * @return The buttons that have been pressed, identified by a bit = 0. 
 *************************************************************************/
extern unsigned char HalButtonsPressedIFG(void)
{
  volatile unsigned char temp = buttonsPressed;
  buttonsPressed = 0;
  return temp;
}

/**********************************************************************//**
 * @brief  Enables button interrupt(s) with low to high transitions.
 * 
 * @param  buttonIntEnableMask The button pin(s) for which the interrupt(s) 
 *                             should be enabled.
 * 
 * @return none
 *************************************************************************/
void HalButtonsInterruptEnable(unsigned char buttonIntEnableMask, unsigned char port)
{
	if(port == PORT1)
	{
		BUTTON_PORT1_IES &= ~buttonIntEnableMask;
		BUTTON_PORT1_IFG &= ~buttonIntEnableMask;
		BUTTON_PORT1_IE |= buttonIntEnableMask;
	}
	else if (port == PORT2)
	{
		BUTTON_PORT2_IES &= ~buttonIntEnableMask;
		BUTTON_PORT2_IFG &= ~buttonIntEnableMask;
		BUTTON_PORT2_IE |= buttonIntEnableMask;
	}

}

/**********************************************************************//**
 * @brief  Disables button interrupts 
 * 
 * @param  buttonIntEnableMask The button pin(s) for which the interrupt(s)
 *                             should be disabled. 
 * 
 * @return none
 *************************************************************************/
void HalButtonsInterruptDisable(unsigned char buttonIntEnableMask, unsigned char port)
{
	if(port == PORT1)
	{
		BUTTON_PORT1_IE &= ~buttonIntEnableMask;
	}
	else if (port == PORT2)
	{
		BUTTON_PORT2_IE &= ~buttonIntEnableMask;
	}
}

/**********************************************************************//**
 * @brief  Clears the button GPIO settings, disables the buttons. 
 * 
 * @param  none
 *************************************************************************/
void HalButtonsShutDown()
{
  //All output, outputting 0s
  BUTTON_PORT1_OUT &= ~(BUTTON_ALL_PORT1);
  BUTTON_PORT1_DIR |= BUTTON_ALL_PORT1;
  BUTTON_PORT2_OUT &= ~(BUTTON_ALL_PORT2);
  BUTTON_PORT2_DIR |= BUTTON_ALL_PORT2;
}
/***************************************************************************//**
 * @brief  Sets up the WDT as a button debouncer, only activated once a
 *         button interrupt has occurred. 
 * @param  none  
 * @return none
 ******************************************************************************/
void HalButtonsStartWDT()
{
  // WDT as 250ms interval counter
  SFRIFG1 &= ~WDTIFG;
  WDTCTL = WDTPW + WDTSSEL_1 + WDTTMSEL + WDTCNTCL + WDTIS_5;
  SFRIE1 |= WDTIE;
}

/***************************************************************************//**
 * @brief  Handles Port 1 interrupts - performs button debouncing and registers
 *         button presses.
 * @param  none   
 * @return none
 ******************************************************************************/
#pragma vector=PORT1_VECTOR
__interrupt void Port1_ISR(void)
{ 
  if (buttonDebounce == 1)   
  {
    buttonsPressed = P1IFG & BUTTON_ALL_PORT1;
    buttonDebounce = 2;   
    HalButtonsStartWDT();     
    __bic_SR_register_on_exit(LPM3_bits);    
  }
  else if (0 == buttonDebounce) 
  {
    buttonsPressed = P1IFG & BUTTON_ALL_PORT1;
    __bic_SR_register_on_exit(LPM4_bits);     
  }   
  P1IFG = 0;
}

/***************************************************************************//**
 * @brief  Handles Port 2 interrupts - performs button debouncing and registers
 *         button presses.
 * @param  none
 * @return none
 ******************************************************************************/
#pragma vector=PORT2_VECTOR
__interrupt void Port2_ISR(void)
{
  if (buttonDebounce == 1)
  {
    buttonsPressed = P2IFG & BUTTON_ALL_PORT2;
    buttonDebounce = 2;
    HalButtonsStartWDT();
    __bic_SR_register_on_exit(LPM3_bits);
  }
  else if (0 == buttonDebounce)
  {
    buttonsPressed = P2IFG & BUTTON_ALL_PORT2;
    __bic_SR_register_on_exit(LPM4_bits);
  }
  P2IFG = 0;
}


/***************************************************************************//**
 * @brief  Handles Watchdog Timer interrupts. 
 *
 *         Global variables are used to determine the module triggering the
 *         interrupt, and therefore, how to handle it.    
 * @param  none  
 * @return none
 ******************************************************************************/
#pragma vector=WDT_VECTOR
__interrupt void WDT_ISR(void)
{
  if (buttonDebounce == 2)
  {
    buttonDebounce = 1;
	  SFRIFG1 &= ~WDTIFG;
	  SFRIE1 &= ~WDTIE;
	  WDTCTL = WDTPW + WDTHOLD;  
  }   
}
