DroningOn/ECE411/Code/RevA/Base CC430F6137/SimpliciTI/Components/bsp/boards/MSP-EXP430F6137Rx/bsp_led_defs.h

/**************************************************************************************************
  Revised:        $Date: 2007-07-06 11:19:00 -0700 (Fri, 06 Jul 2007) $
  Revision:       $Revision: 13579 $

  Copyright 2007 Texas Instruments Incorporated.  All rights reserved.

  IMPORTANT: Your use of this Software is limited to those specific rights granted under
  the terms of a software license agreement between the user who downloaded the software,
  his/her employer (which must be your employer) and Texas Instruments Incorporated (the
  "License"). You may not use this Software unless you agree to abide by the terms of the
  License. The License limits your use, and you acknowledge, that the Software may not be
  modified, copied or distributed unless embedded on a Texas Instruments microcontroller
  or used solely and exclusively in conjunction with a Texas Instruments radio frequency
  transceiver, which is integrated into your product. Other than for the foregoing purpose,
  you may not use, reproduce, copy, prepare derivative works of, modify, distribute,
  perform, display or sell this Software and/or its documentation for any purpose.

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
  Should you have any questions regarding your right to use this Software,
  contact Texas Instruments Incorporated at www.TI.com.
**************************************************************************************************/

/* =-=-=-=-=-=-=-=-=-=-=-=-=-=-=-=-=-=-=-=-=-=-=-=-=-=
 *   BSP (Board Support Package)
 *   Target : Texas Instruments CC430EM
 *   LED definition file.
 * =-=-=-=-=-=-=-=-=-=-=-=-=-=-=-=-=-=-=-=-=-=-=-=-=-=
 */

#ifndef BSP_LED_DEFS_H
#define BSP_LED_DEFS_H


/* ------------------------------------------------------------------------------------------------
 *                                           Includes
 * ------------------------------------------------------------------------------------------------
 */
#include "bsp_board_defs.h"


/* ------------------------------------------------------------------------------------------------
 *                                      Configuration
 * ------------------------------------------------------------------------------------------------
 */
#define __bsp_NUM_LEDS__               0
#define __bsp_LED_BLINK_LOOP_COUNT__   0x34000


/* ~~~~~~~~~~~~~~~~~~~~~~~~~~~~~~~~~~~~~~~
 *                 LED #1
 * ~~~~~~~~~~~~~~~~~~~~~~~~~~~~~~~~~~~~~~~
 *   Schematic :  LED1
 *   Color     :  Green
 *   Polarity  :  Active High
 *   GPIO      :  P1.0
 * ~~~~~~~~~~~~~~~~~~~~~~~~~~~~~~~~~~~~~~~
 */
/*
#define __bsp_LED1_BIT__            0
#define __bsp_LED1_PORT__           P1OUT
#define __bsp_LED1_DDR__            P1DIR
#define __bsp_LED1_IS_ACTIVE_LOW__  0

*/
/* ~~~~~~~~~~~~~~~~~~~~~~~~~~~~~~~~~~~~~~~
 *                 LED #2
 * ~~~~~~~~~~~~~~~~~~~~~~~~~~~~~~~~~~~~~~~
 *   Schematic :  LED2
 *   Color     :  Green
 *   Polarity  :  Active High
 *   GPIO      :  P3.6
 * ~~~~~~~~~~~~~~~~~~~~~~~~~~~~~~~~~~~~~~~
 */
 /*
#define __bsp_LED2_BIT__            6
#define __bsp_LED2_PORT__           P3OUT
#define __bsp_LED2_DDR__            P3DIR
#define __bsp_LED2_IS_ACTIVE_LOW__  0
*/

/* ------------------------------------------------------------------------------------------------
 *                                 Include Generic LED Macros
 * ------------------------------------------------------------------------------------------------
 */
#include "code/bsp_generic_leds.h"


/**************************************************************************************************
 */
#endif
