DroningOn/ECE411/Code/RevA/Satellite CC430F5137/SimpliciTI/Application/application/End_Device/main_manyEDs.c

/*----------------------------------------------------------------------------
 *  Demo Application for SimpliciTI
 *
 *  L. Friedman
 *  Texas Instruments, Inc.
 *---------------------------------------------------------------------------- */

/**********************************************************************************************
  Copyright 2007-2008 Texas Instruments Incorporated. All rights reserved.

  IMPORTANT: Your use of this Software is limited to those specific rights granted under
  the terms of a software license agreement between the user who downloaded the software,
  his/her employer (which must be your employer) and Texas Instruments Incorporated (the
  "License"). You may not use this Software unless you agree to abide by the terms of the
  License. The License limits your use, and you acknowledge, that the Software may not be
  modified, copied or distributed unless embedded on a Texas Instruments microcontroller
  or used solely and exclusively in conjunction with a Texas Instruments radio frequency
  transceiver, which is integrated into your product. Other than for the foregoing purpose,
  you may not use, reproduce, copy, prepare derivative works of, modify, distribute,
  perform, display or sell this Software and/or its documentation for any purpose.

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
  Should you have any questions regarding your right to use this Software,
  contact Texas Instruments Incorporated at www.TI.com.
**************************************************************************************************/

#include "bsp.h"
#include "mrfi.h"
#include "nwk_types.h"
#include "nwk_api.h"
#include "bsp_leds.h"
#include "bsp_buttons.h"



static void linkTo(void);

void toggleLED(uint8_t);

static uint8_t sTid = 0;

/* Callback handler */
static uint8_t sCB(linkID_t);

static volatile uint8_t  sPeerFrameSem = 0;
static          linkID_t sLinkID1 = 0;

#define SPIN_ABOUT_A_SECOND   NWK_DELAY(1000)
#define SPIN_ABOUT_A_QUARTER_SECOND   NWK_DELAY(250)

/* How many times to try a Tx and miss an acknowledge before doing a scan */
#define MISSES_IN_A_ROW  2

void main (void)
{
  BSP_Init();

  /* If an on-the-fly device address is generated it must be done before the
   * call to SMPL_Init(). If the address is set here the ROM value will not
   * be used. If SMPL_Init() runs before this IOCTL is used the IOCTL call
   * will not take effect. One shot only. The IOCTL call below is conformal.
   */
#ifdef I_WANT_TO_CHANGE_DEFAULT_ROM_DEVICE_ADDRESS_PSEUDO_CODE
  {
    addr_t lAddr;

    createRandomAddress(&lAddr);
    SMPL_Ioctl(IOCTL_OBJ_ADDR, IOCTL_ACT_SET, &lAddr);
  }
#endif /* I_WANT_TO_CHANGE_DEFAULT_ROM_DEVICE_ADDRESS_PSEUDO_CODE */

  /* Keep trying to join (a side effect of successful initialization) until
   * successful. Toggle LEDS to indicate that joining has not occurred.
   */
  while (SMPL_SUCCESS != SMPL_Init(sCB))
  {
    toggleLED(1);
    toggleLED(2);
    SPIN_ABOUT_A_SECOND;
  }

  /* LEDs on solid to indicate successful join. */
  if (!BSP_LED2_IS_ON())
  {
    toggleLED(2);
  }
  if (!BSP_LED1_IS_ON())
  {
    toggleLED(1);
  }

  /* Unconditional link to AP which is listening due to successful join. */
  linkTo();

  while (1) ;
}



static void linkTo()
{
  uint8_t     msg[2];
  uint8_t     button, misses, done;

  /* Keep trying to link... */
  while (SMPL_SUCCESS != SMPL_Link(&sLinkID1))
  {
    toggleLED(1);
    toggleLED(2);
    SPIN_ABOUT_A_SECOND;
  }

  /* Turn off LEDs. */
  if (BSP_LED2_IS_ON())
  {
    toggleLED(2);
  }
  if (BSP_LED1_IS_ON())
  {
    toggleLED(1);
  }

  /* sleep until button press... */
  SMPL_Ioctl( IOCTL_OBJ_RADIO, IOCTL_ACT_RADIO_SLEEP, 0);

  while (1)
  {
    button = 0;
    /* Send a message when either button pressed */
    if (BSP_BUTTON1())
    {
      SPIN_ABOUT_A_QUARTER_SECOND;  /* debounce... */
      /* Message to toggle LED 1. */
      button = 1;
    }
    else if (BSP_BUTTON2())
    {
      SPIN_ABOUT_A_QUARTER_SECOND;  /* debounce... */
      /* Message to toggle LED 2. */
      button = 2;
    }
    if (button)
    {
      /* get radio ready...awakens in idle state */
      SMPL_Ioctl( IOCTL_OBJ_RADIO, IOCTL_ACT_RADIO_AWAKE, 0);

      /* Set TID and designate which LED to toggle */
      msg[1] = ++sTid;
      msg[0] = (button == 1) ? 1 : 2;
      done = 0;
      while (!done)
      {
        for (misses=0; misses < MISSES_IN_A_ROW; ++misses)
        {
          if (SMPL_SUCCESS == SMPL_Send(sLinkID1, msg, sizeof(msg)))
          {
#if defined( FREQUENCY_AGILITY )
            /* If macro is defined we're supporting Frequency Agility. In this case
             * the peer will acknowledge the message sent. It is the only way we can
             * tell if we are on the right channel. Wait for ack.
             */
            {
              bspIState_t intState;

              SMPL_Ioctl( IOCTL_OBJ_RADIO, IOCTL_ACT_RADIO_RXON, 0);
              NWK_REPLY_DELAY();
              SMPL_Ioctl( IOCTL_OBJ_RADIO, IOCTL_ACT_RADIO_RXIDLE, 0);

              if (!sPeerFrameSem)
              {
                /* Try again if we havn't received anything. */
                continue;
              }
              else
              {
                uint8_t len;

                BSP_ENTER_CRITICAL_SECTION(intState);
                sPeerFrameSem--;
                BSP_EXIT_CRITICAL_SECTION(intState);

                /* We got something. Go get it. */
                SMPL_Receive(sLinkID1, msg, &len);
                if (len && (*msg & NWK_APP_REPLY_BIT))
                {
                  toggleLED(*msg & ~NWK_APP_REPLY_BIT);
                  break;
                }
              }
            }
#else
            /* Not supporting Frequency agility. Just break out since there
             * will be no ack.
             */
            break;
#endif
          }
        }
        if (misses == MISSES_IN_A_ROW)
        {
          /* This can only happen if we are supporting Frequency Agility and we
           * appear not to have received an acknowledge. Do a scan.
           */
          ioctlScanChan_t scan;
          freqEntry_t     freq[NWK_FREQ_TBL_SIZE];

          scan.freq = freq;
          SMPL_Ioctl(IOCTL_OBJ_FREQ, IOCTL_ACT_SCAN, &scan);
          /* If we now know the channel (number == 1) change to it. In any case
           * try it all again. If we changed channels we should get an ack now.
           */
          if (1 == scan.numChan)
          {
            SMPL_Ioctl(IOCTL_OBJ_FREQ, IOCTL_ACT_SET, freq);
          }
        }
        else
        {
          /* Got the ack. We're done. */
          done = 1;
        }
      }

      /* radio back to sleep */
      SMPL_Ioctl( IOCTL_OBJ_RADIO, IOCTL_ACT_RADIO_SLEEP, 0);
    }
  }
}


void toggleLED(uint8_t which)
{
  if (1 == which)
  {
    BSP_TOGGLE_LED1();
  }
  else if (2 == which)
  {
    BSP_TOGGLE_LED2();
  }
  return;
}

static uint8_t sCB(linkID_t lid)
{
  if (lid == sLinkID1)
  {
    sPeerFrameSem++;
    return 0;
  }

  return 1;
}
