DroningOn/ECE411/Code/CC430F513x Code Examples/cc430x513x_uscib0_i2c_06.c

/* --COPYRIGHT--,BSD
 * Copyright (c) 2012, Texas Instruments Incorporated
 * All rights reserved.
 *
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
 * *  Redistributions of source code must retain the above copyright
 *    notice, this list of conditions and the following disclaimer.
 *
 * *  Redistributions in binary form must reproduce the above copyright
 *    notice, this list of conditions and the following disclaimer in the
 *    documentation and/or other materials provided with the distribution.
 *
 * *  Neither the name of Texas Instruments Incorporated nor the names of
 *    its contributors may be used to endorse or promote products derived
 *    from this software without specific prior written permission.
 *
 * THIS SOFTWARE IS PROVIDED BY THE COPYRIGHT HOLDERS AND CONTRIBUTORS "AS IS"
 * AND ANY EXPRESS OR IMPLIED WARRANTIES, INCLUDING, BUT NOT LIMITED TO,
 * THE IMPLIED WARRANTIES OF MERCHANTABILITY AND FITNESS FOR A PARTICULAR
 * PURPOSE ARE DISCLAIMED. IN NO EVENT SHALL THE COPYRIGHT OWNER OR
 * CONTRIBUTORS BE LIABLE FOR ANY DIRECT, INDIRECT, INCIDENTAL, SPECIAL,
 * EXEMPLARY, OR CONSEQUENTIAL DAMAGES (INCLUDING, BUT NOT LIMITED TO,
 * PROCUREMENT OF SUBSTITUTE GOODS OR SERVICES; LOSS OF USE, DATA, OR PROFITS;
 * OR BUSINESS INTERRUPTION) HOWEVER CAUSED AND ON ANY THEORY OF LIABILITY,
 * WHETHER IN CONTRACT, STRICT LIABILITY, OR TORT (INCLUDING NEGLIGENCE OR
 * OTHERWISE) ARISING IN ANY WAY OUT OF THE USE OF THIS SOFTWARE,
 * EVEN IF ADVISED OF THE POSSIBILITY OF SUCH DAMAGE.
 * --/COPYRIGHT--*/
//******************************************************************************
//  CC430F513x Demo - USCI_B0 I2C Master TX single bytes to MSP430 Slave
//
//  Description: This demo connects two MSP430's via the I2C bus. The master
//  transmits to the slave. This is the master code. It continuously
//  transmits 00h, 01h, ..., 0ffh and demonstrates how to implement an I2C
//  master transmitter sending a single byte using the USCI_B0 TX interrupt.
//  ACLK = n/a, MCLK = SMCLK = BRCLK = default DCO = ~1.045MHz
//
// *** to be used with "cc430x513x_uscib0_i2c_07.c" ***
//
//                                /|\  /|\
//               CC430F5137      10k  10k     CC430F5137
//                   slave         |    |        master
//             -----------------   |    |   -----------------
//           -|XIN  P1.3/UCB0SDA|<-|----+->|P1.3/UCB0SDA  XIN|-
//            |                 |  |       |                 | 32kHz
//           -|XOUT             |  |       |             XOUT|-
//            |     P1.2/UCB0SCL|<-+------>|P1.2/UCB0SCL     |
//            |                 |          |             P1.0|--> LED
//
//   M Morales
//   Texas Instruments Inc.
//   April 2009
//   Built with CCE Version: 3.2.2 and IAR Embedded Workbench Version: 4.11B
//******************************************************************************

#include <msp430.h>

unsigned char TXData;
unsigned char TXByteCtr;

int main(void)
{
  WDTCTL = WDTPW + WDTHOLD;                 // Stop WDT
  
  PMAPPWD = 0x02D52;                        // Get write-access to port mapping regs  
  P1MAP3 = PM_UCB0SDA;                      // Map UCB0SDA output to P1.3 
  P1MAP2 = PM_UCB0SCL;                      // Map UCB0SCL output to P1.2 
  PMAPPWD = 0;                              // Lock port mapping registers 
  
  P1SEL |= BIT2 + BIT3;                     // Select P1.2 & P1.3 to I2C function
    
  UCB0CTL1 |= UCSWRST;                      // Enable SW reset
  UCB0CTL0 = UCMST + UCMODE_3 + UCSYNC;     // I2C Master, synchronous mode
  UCB0CTL1 = UCSSEL_2 + UCSWRST;            // Use SMCLK, keep SW reset
  UCB0BR0 = 12;                             // fSCL = SMCLK/12 = ~100kHz
  UCB0BR1 = 0;
  UCB0I2CSA = 0x48;                         // Slave Address is 048h
  UCB0CTL1 &= ~UCSWRST;                     // Clear SW reset, resume operation
  UCB0IE |= UCTXIE;                         // Enable TX interrupt

  TXData = 0x01;                            // Holds TX data

  while (1)
  {
    TXByteCtr = 1;                          // Load TX byte counter

    while (UCB0CTL1 & UCTXSTP);             // Ensure stop condition got sent
    UCB0CTL1 |= UCTR + UCTXSTT;             // I2C TX, start condition
   
    __bis_SR_register(LPM0_bits + GIE);     // Enter LPM0 w/ interrupts
    __no_operation();                       // Remain in LPM0 until all data
                                            // is TX'd
                                              
    TXData++;                               // Increment data byte
  }
}

//------------------------------------------------------------------------------
// The USCIAB0_ISR is structured such that it can be used to transmit any
// number of bytes by pre-loading TXByteCtr with the byte count.
//------------------------------------------------------------------------------
#if defined(__TI_COMPILER_VERSION__) || defined(__IAR_SYSTEMS_ICC__)
#pragma vector = USCI_B0_VECTOR
__interrupt void USCI_B0_ISR(void)
#elif defined(__GNUC__)
void __attribute__ ((interrupt(USCI_B0_VECTOR))) USCI_B0_ISR (void)
#else
#error Compiler not supported!
#endif
{
  switch(__even_in_range(UCB0IV,12))
  {
  case  0: break;                           // Vector  0: No interrupts
  case  2: break;                           // Vector  2: ALIFG
  case  4: break;                           // Vector  4: NACKIFG
  case  6: break;                           // Vector  6: STTIFG
  case  8: break;                           // Vector  8: STPIFG
  case 10: break;                           // Vector 10: RXIFG
  case 12:                                  // Vector 12: TXIFG  
    if (TXByteCtr)                          // Check TX byte counter
    {
      UCB0TXBUF = TXData;                   // Load TX buffer
      TXByteCtr--;                          // Decrement TX byte counter
    }
    else
    {
      UCB0CTL1 |= UCTXSTP;                  // I2C stop condition
      UCB0IFG &= ~UCTXIFG;                  // Clear USCI_B0 TX int flag
      __bic_SR_register_on_exit(LPM0_bits); // Exit LPM0
    }
    break;
  default: break;
  }
}
