DroningOn/ECE411/Code/CC430F513x Code Examples/!cc430f513x_c_code_examples.js

var jsonInfo = [
	{
		"MCU"    : "MSP430",
		"Device" : "CC430F513x",
		"Filter" : "CC430F513\\d"
	}
];

var jsonObjC = [
	{"SourcePreview" : "cc430x513x_adc12_01.c",                "Description" : "ADC12, Sample A0, Set P1.0 if A0 > 0.5*AVcc"},
	{"SourcePreview" : "cc430x513x_adc12_02.c",                "Description" : "ADC12, Using the Internal Reference"},
	{"SourcePreview" : "cc430x513x_adc12_05.c",                "Description" : "ADC12, Using an External Reference"},
	{"SourcePreview" : "cc430x513x_adc12_06.c",                "Description" : "ADC12, Repeated Sequence of Conversions"},
	{"SourcePreview" : "cc430x513x_adc12_07.c",                "Description" : "ADC12, Repeated Single Channel Conversions"},
	{"SourcePreview" : "cc430x513x_adc12_09.c",                "Description" : "ADC12, Sequence of Conversions (non-repeated)"},
	{"SourcePreview" : "cc430x513x_adc12_10.c",                "Description" : "ADC12, Sample A10 Temp and Convert to oC and oF"},
	{"SourcePreview" : "cc430x513x_compB_01.c",                "Description" : "COMPB output Toggle in LPM4; internal 2.0V reference"},
	{"SourcePreview" : "cc430x513x_compB_03.c",                "Description" : "COMPB interrupts; internal 1.5V reference"},
	{"SourcePreview" : "cc430x513x_compB_04.c",                "Description" : "CBOUT from LPM4; CompB in ultra low power mode; Vref = Vcc*1/2"},
	{"SourcePreview" : "cc430x513x_compB_05.c",                "Description" : "COMPB Hysteresis, CBOUT Toggle in LPM4; High speed mode"},
	{"SourcePreview" : "cc430x513x_compB_06.c",                "Description" : "COMPB and TIMERAx interaction (TA0.1, TA1.1)"},
	{"SourcePreview" : "cc430x513x_core_01.c",                 "Description" : "Reset on Invalid Address fetch, Toggle P1.0"},
	{"SourcePreview" : "cc430x513x_dma_01.c",                  "Description" : "DMA0, Repeated Block to-from RAM, Software Trigger"},
	{"SourcePreview" : "cc430x513x_dma_02.c",                  "Description" : "DMA0, Single Transfer in Block Mode UART1 9600, ACLK"},
	{"SourcePreview" : "cc430x513x_dma_03.c",                  "Description" : "SPI TX & RX using DMA0 & DMA1 Single Transfer in Fixed Address Mode"},
	{"SourcePreview" : "cc430x513x_dma_04.c",                  "Description" : "DMA0, Single transfer using ADC12 triggered by TimerB"},
	{"SourcePreview" : "cc430x513x_dma_05.c",                  "Description" : "USCI_A0, 115200 UART RX & TX, DMA enabled"},
	{"SourcePreview" : "cc430x513x_flashwrite_01.c",           "Description" : "Single-Byte Flash In-System Programming, Copy SegC to SegD"},
	{"SourcePreview" : "cc430x513x_flashwrite_02.c",           "Description" : "Flash In-System Programming w/ Long-Word write at 0x1800"},
	{"SourcePreview" : "cc430x513x_LPM3_1.c",                  "Description" : "Enters LPM3 (ACLK = LFXT1)"},
	{"SourcePreview" : "cc430x513x_LPM3_2.c",                  "Description" : "Enters LPM3 (ACLK = VLO)"},
	{"SourcePreview" : "cc430x513x_OF_LFXT1_nmi.c",            "Description" : "LFXT1 Oscillator Fault Detection"},
	{"SourcePreview" : "cc430x513x_P1_01.c",                   "Description" : "Software Poll P1.4, Set P1.0 if P1.4 = 1"},
	{"SourcePreview" : "cc430x513x_P1_02.c",                   "Description" : "Software Port interrupt on P1.4 from LPM4; Internal Pull-up "},
	{"SourcePreview" : "cc430x513x_P1_05.c",                   "Description" : "Write a byte to Port 1"},
	{"SourcePreview" : "cc430x513x_PA_05.c",                   "Description" : "Write a Word to Port A (Port1+Port2)"},
	{"SourcePreview" : "cc430x513x_PortMap_01.c",              "Description" : "Port Mapping Port2; Single runtime configuration"},
	{"SourcePreview" : "cc430x513x_PortMap_02.c",              "Description" : "Port Mapping single function to multiple pins;"},
	{"SourcePreview" : "cc430x513x_PortMap_03.c",              "Description" : "Port Map single function to multiple pins; Multiple runtime configurations"},
	{"SourcePreview" : "cc430x513x_RTC_01.c",                  "Description" : "RTC in Counter Mode toggles P1.0 every 1s"},
	{"SourcePreview" : "cc430x513x_ta3_01.c",                  "Description" : "Timer_A3, Toggle P1.0, CCR0 Cont. Mode ISR, DCO SMCLK"},
	{"SourcePreview" : "cc430x513x_ta3_02.c",                  "Description" : "Timer_A3, Toggle P1.0, CCR0 Up Mode ISR, DCO SMCLK"},
	{"SourcePreview" : "cc430x513x_ta3_03.c",                  "Description" : "Timer_A3, Toggle P1.0, Overflow ISR, DCO SMCLK"},
	{"SourcePreview" : "cc430x513x_ta3_04.c",                  "Description" : "Timer_A3, Toggle P1.0, Overflow ISR, 32kHz ACLK"},
	{"SourcePreview" : "cc430x513x_ta3_05.c",                  "Description" : "Timer_A3, Toggle P1.0, CCR0 Up Mode ISR, 32kHz ACLK"},
	{"SourcePreview" : "cc430x513x_ta3_08.c",                  "Description" : "Timer_A3, Toggle P1.0;P2.1-3, Cont. Mode ISR, 32kHz ACLK"},
	{"SourcePreview" : "cc430x513x_ta3_11.c",                  "Description" : "Timer_A3, Toggle P2.1/TA1.0, Up Mode, 32kHz ACLK"},
	{"SourcePreview" : "cc430x513x_ta3_13.c",                  "Description" : "Timer_A3, Toggle P2.1/TA1.0, Up/Down Mode, DCO SMCLK"},
	{"SourcePreview" : "cc430x513x_ta3_14.c",                  "Description" : "Timer_A3, Toggle P2.1/TA1.0, Up/Down Mode, 32kHz ACLK"},
	{"SourcePreview" : "cc430x513x_ta3_16.c",                  "Description" : "Timer_A3, PWM TA1.1-2, Up Mode, DCO SMCLK"},
	{"SourcePreview" : "cc430x513x_ta3_17.c",                  "Description" : "Timer_A3, PWM TA1.1-2, Up Mode, 32kHz ACLK"},
	{"SourcePreview" : "cc430x513x_ta3_19.c",                  "Description" : "Timer_A3, PWM TA1.1-2, Up/Down Mode, DCO SMCLK"},
	{"SourcePreview" : "cc430x513x_ta3_20.c",                  "Description" : "Timer_A3, PWM TA1.1-2, Up/Down Mode, 32kHz ACLK"},
	{"SourcePreview" : "cc430x513x_UCS_1.c",                   "Description" : "Software Toggle P1.0 at Default DCO"},
	{"SourcePreview" : "cc430x513x_UCS_2.c",                   "Description" : "Software Toggle P1.0 with 8MHz DCO"},
	{"SourcePreview" : "cc430x513x_UCS_3.c",                   "Description" : "Software Toggle P1.0 with 12MHz DCO"},
	{"SourcePreview" : "cc430x513x_UCS_4.c",                   "Description" : "FLL+, Runs Internal DCO at 2.45MHz with LFXT1 as Ref"},
	{"SourcePreview" : "cc430x513x_UCS_5.c",                   "Description" : "VLO sources ACLK"},
	{"SourcePreview" : "cc430x513x_UCS_6.c",                   "Description" : "XT1 sources ACLK. Toggles P1.0"},
	{"SourcePreview" : "cc430x513x_UCS_7.c",                   "Description" : "FLL+, Output 32kHz Xtal + HF Xtal + Internal DCO"},
	{"SourcePreview" : "cc430x513x_UCS_8.c",                   "Description" : "XT2 sources MCLK & SMCLK"},
	{"SourcePreview" : "cc430x513x_UCS_9.c",                   "Description" : "LFXT1 HF Xtal + Internal DCO"},
	{"SourcePreview" : "cc430x513x_uscia0_duplex_9600.c",      "Description" : "USCI_A0, UART 9600 Full-Duplex Transceiver, 32K ACLK"},
	{"SourcePreview" : "cc430x513x_uscia0_spi_09.c",           "Description" : "USCI_A0, SPI 3-Wire Master Incremented Data"},
	{"SourcePreview" : "cc430x513x_uscia0_spi_10.c",           "Description" : "USCI_A0, SPI 3-Wire Slave Data Echo"},
	{"SourcePreview" : "cc430x513x_uscia0_uart_01.c",          "Description" : "USCI_A0, 115200 UART Echo ISR, DCO SMCLK"},
	{"SourcePreview" : "cc430x513x_uscia0_uart_02.c",          "Description" : "USCI_A0, Ultra-Low Pwr UART 2400 Echo ISR, 32kHz ACLK"},
	{"SourcePreview" : "cc430x513x_uscia0_uart_03.c",          "Description" : "USCI_A0, Ultra-Low Pwr UART 9600 Echo ISR, 32kHz ACLK"},
	{"SourcePreview" : "cc430x513x_uscia0_uart_04.c",          "Description" : "USCI_A0, 9600 UART, SMCLK, LPM0, Echo with over-sampling"},
	{"SourcePreview" : "cc430x513x_uscib0_i2c_04.c",           "Description" : "USCI_B0 I2C Master RX single bytes from cc430 Master"},
	{"SourcePreview" : "cc430x513x_uscib0_i2c_05.c",           "Description" : "USCI_B0 I2C Slave TX single bytes to cc430 Slave"},
	{"SourcePreview" : "cc430x513x_uscib0_i2c_06.c",           "Description" : "USCI_B0 I2C Master TX single bytes to cc430 Slave"},
	{"SourcePreview" : "cc430x513x_uscib0_i2c_07.c",           "Description" : "USCI_B0 I2C Slave RX single bytes from cc430 Master"},
	{"SourcePreview" : "cc430x513x_uscib0_i2c_08.c",           "Description" : "USCI_B0 I2C Master TX multiple bytes to cc430 Slave"},
	{"SourcePreview" : "cc430x513x_uscib0_i2c_09.c",           "Description" : "USCI_B0 I2C Slave RX multiple bytes from cc430 Master"},
	{"SourcePreview" : "cc430x513x_uscib0_i2c_10.c",           "Description" : "USCI_B0 I2C Master RX multiple bytes from cc430 Slave"},
	{"SourcePreview" : "cc430x513x_uscib0_i2c_11.c",           "Description" : "USCI_B0 I2C Slave TX multiple bytes to cc430 Master"},
	{"SourcePreview" : "cc430x513x_wdt_01.c",                  "Description" : "WDT, Toggle P1.0, Interval Overflow ISR, DCO SMCLK"},
	{"SourcePreview" : "cc430x513x_wdt_02.c",                  "Description" : "WDT, Toggle P1.0, Interval Overflow ISR, 32kHz ACLK"},
	{"SourcePreview" : "cc430x513x_wdt_04.c",                  "Description" : "WDT+ Failsafe Clock, WDT mode, DCO SMCLK"}
];
