DroningOn/ECE411/(commit log)

2014-10-11 MCU Info
    [MCU_Prices.xlsx]
2014-10-15 Wiki Materials
2014-10-15 CP2130 SPI-USB Bridge
    These datasheets describe the Silicon Labs CP2130 SPI to USB bridge IC
    and programming interface.
2014-10-16 Created Schematic with Part and Footprint
    Board Schematic has an Eagle project with the CC430F513x placed already.
    I included a separate folder with the library holding the footprints for
    the MSP430 series that might need to be installed on your end.
    [main.sch]
2014-10-16 Rename for clarity.
    [main.sch]
2014-10-16 Schematic update
    Set up skeleton for match network on RF path. Inductor footprint
    probably needs to be changed.
    [main.sch]
2014-10-16 Ripped component libs out of dev kit schematics
    Wanted rlc_amber for SMD inductor footprints that eagle seemed to
    neglect.. like 0603. Pin headers might be useful later as well.
    [MSP-EXP430F5137RxT_HW-V2.sch, MSP-EXP430F5137RxT_HW-V2_rev-b.brd, MSP-EXP430F6137Rx-HW-V2.sch, MSP-EXP430F6137Rx-HW-V2_rev-b.brd]
2014-10-16 Inductors updated with rlc_amber components
    [main.sch]
2014-10-16 PCB Antenna Stuff
    Baluns and filter network layed out, need to incorperate matching
    network (probably pi) and get a footprint kicked out for monopole
    antenna. NEED specs on substrate to do this correctly.
    [main.sch]
2014-10-17 Schematics & Board Layout Checklist
    See issue "PCB Checklist"
2014-10-17 Addl' Eagle Libraries and Datasheets
    The TI recommended CC430 to USB application note is really just for my
    own reference. They suggested using their own USB bridge requiring two
    chips; one chip is for the bridge, and another for eeprom parameter
    storage. That option isn't ideal, so we will use another option.
    [T08 USB Radio Receiver.sch, main.sch]
2014-10-18 Project Files for Antenna Design
    Agilent ADS working files
    [de_sim.cfg, hpeesofsim.cfg]
2014-10-18 Antenna files update.
    [de_sim.cfg]
2014-10-18 Created HW Documents Folder in Wiki Materials
    Put assignments here and link to ECE411 Documents on Wiki
2014-10-19 Eagle Libraries and Datasheets
    Created part for CR2032 surface mount battery holder.
    Added CC430 capacitive sensor application note.
2014-10-19 Schematic Update
    Added decoupling capacitors, JTAG interface, annotation.
2014-10-21 Revert "Schematic Update"
    This reverts commit 5abb39e3185d2877969b4b6a32f7c4948c4e0dd3.
    [main.sch]
2014-10-21 ADS Antenna Geometry with matching network solve
    Finished tuning simulations and creating match network for 915MHz,
    guessing no one else in the group has ADS so I will be migrating the
    specs into eagle this week.
    [dds.cfg, de_sim.cfg, linecalc.cfg, proj.cfg, proj.prt, proj_geo.csv]
2014-10-24 Antenna work and radio datasheets
2014-10-24 Tx-Schematic Added
    Additional eagle libraries; setup info added to datasheet section.
    [T08 USB Radio Receiver.sch, T08-TxClicker.brd, T08-TxClicker.sch, main.sch]
2014-10-24 Antenna Eagle Sym and Layout
2014-10-24 Layout Work
    [T08-TxClicker.brd]
2014-10-25 Materials BOM
    Created BOM, made pushbuttons larger on PCB
    [T08-TxClicker.brd, T08-TxClicker.sch, T08-TxClicker_BOM.xlsx]
2014-10-25 Quick board review.
    [T08-TxClicker.brd, T08-TxClicker.sch]
2014-10-26 Paranoid Push of BOM (WIP)
    [T08-TxClicker_BOM.xlsx]
2014-10-27 Tx-Schematic Update for Team Review
    Removed triple redundant capacitive sensor, removed MOSFET LED drivers,
    changed RF signal path to 0402 capacitors from 0603.
    [T08-TxClicker.brd, T08-TxClicker_BOM.xlsx]
2014-10-27 Tx-Schematic update
    [T08-TxClicker.brd, T08-TxClicker.sch]
2014-10-27 Tx-Schematic Update
    Changed pull-down to 10Meg, changed JTAG EMI cap from DNI to 2pF,
    Annotated JTAG as Tag-Connect
    [T08-TxClicker.brd, T08-TxClicker.sch]
2014-10-27 TX_Schematic Update
    [T08-TxClicker.sch]
2014-10-27 Eagle Library Update
    [T08-TxClicker.sch]
2014-10-29 Antenna Field Stuff
    Needs to be updated again anyways because we know more about Gplane
    dimensions on the board now.
2014-10-29 Tidying up files
    Zipped old remote board and deleted source directory to avoid confusion.
    Created dated zip of active directory for sending files to others.
    [main.sch]
2014-10-29 Added GPIO TP
    [T08-TxClicker.brd, T08-TxClicker.sch]
2014-10-29 Schematic update
    [T08-TxClicker.sch]
2014-11-05 Touchpad switch layout lib updates
    TOUCHPAD_SWITCH_COMBO
2014-11-05 Eagle BRD Layout
    Incomplete, first pass layout
    [T08-TxClicker.brd, T08-TxClicker.sch]
2014-11-05 Layout works
    o.O
    [T08-TxClicker.brd, T08-TxClicker.sch, linecalc.cfg]
2014-11-05 Eagle BRD Layout (rough)
    Squawk list:
    1) Antenna Pad
    2) Pushbutton pad
    3) VCC
    4) Capacitors not near pins
    5) Must optimize routing
    6) Add ground test point
    7) Fix GPIO Test points in schematic
    [T08-TxClicker.brd, T08-TxClicker.sch]
2014-11-08 Board relayout
    prelim, just a status update
    [T08-TxClicker-Rev1a.brd, T08-TxClicker-Rev1a.sch]
2014-11-08 Board relayout
    Another check in.. tired going to bed.
2014-11-08 Schematic directory clean
2014-11-08 Layout Update
    [T08-TxClicker-Rev1a.brd]
2014-11-08 50 Ohm Change
    Fat fingered dielectric constant in earlier calcs, fixed.
2014-11-08 LED reroute
2014-11-08 Tag connect part edit
    Based off mechanical drawings this should be a legit edit.. connector
    will be a bit wider on board but spacing should make it easier to sneak
    wires out.
2014-11-08 Pushed connector holes back 25mil
2014-11-08 Button Example
    [T08-TxClicker-Rev1a.brd, T08-TxClicker-Rev1a.sch]
2014-11-08 DRC free button
2014-11-09 Antenna redraw to reduce DRC
2014-11-09 Arranging silkscreen
    [T08-TxClicker-Rev1a.brd, T08-TxClicker-Rev1a.sch]
2014-11-09 More Silkscreen
    [T08-TxClicker-Rev1a.brd]
2014-11-09 Sparkfun master libs
    Yay footprints...
2014-11-09 And looking decent 0.o
    [T08-TxClicker-Rev1a.brd, T08-TxClicker-Rev1a.sch]
2014-11-09 fill and crystal tweak
    [T08-TxClicker-Rev1a.brd]
2014-11-09 Move Tag Connect
    Vectorized fonts, moved tag connect, added tp labels
    [T08-TxClicker-Rev1a.brd, T08-TxClicker-Rev1a.sch]
2014-11-09 Reset "switch"
    [T08-TxClicker-Rev1a.brd, T08-TxClicker-Rev1a.sch]
2014-11-09 Added Measures and Layer Documentation
    [T08-TxClicker-Rev1a.brd]
2014-11-09 Approved layer documentation errors
    [T08-TxClicker-Rev1a.brd]
2014-11-09 moved some silkscreen
    [T08-TxClicker-Rev1a.brd]
2014-11-09 Added M2 holes for board cover
    In case we decide to install a bamboo cover with nice engravings on top.
    [T08-TxClicker-Rev1a.brd]
2014-11-09 Logo ftw?
    [T08-TxClicker-Rev1a.brd]
2014-11-09 Merge remote-tracking branch 'origin/master'
    Conflicts:
    Eagle/Schematics & Board Layout/Tx Board
    Schematic/T08-TxClicker-Rev1a.brd
    [T08-TxClicker-Rev1a.brd]
2014-11-09 Fixed all the component name overlaps with tStop
    Rest of tStop errors are from tPlace stuff, not fixing because I know
    how OSHPark treats that stuff
    [T08-TxClicker-Rev1a.brd]
2014-11-09 Remove Empty layers, Added M2 holes
    [T08-TxClicker-Rev1a.brd]
2014-11-09 Antenna geometry 0 width fix
    Pushed a DXF and freaked out cause antenna had no fill. Fixed by giving
    the poly a 1mil (I think or maybe 1um, doesn't matter) line width
2014-11-09 Lib to document push
    [T08-TxClicker-Rev1a.brd, T08-TxClicker-Rev1a.sch]
2014-11-10 Project Schedule rev 2
    Modified a couple dates
    Finished adding resources to tasks
    Finished load-leveling
2014-11-12 Updated silkscreen, added board preview
    [T08-TxClicker-Rev1a.brd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]
2014-11-13 Updated links to schematics and layout
2014-11-13 BOM Update
    [T08-TxClicker_BOM.xlsx]
2014-11-19 Schematic Documentation for HW6
2014-11-24 Rev 3
    -Changed a couple variables
    -Began Commenting
2014-11-27 Working Rev
    -Polling duration drop down now sets polling duration
    -Added working Start Button and Stop Button
    -Bar graph now resets all bars to 0 upon new polling
    -Added countdown timer till end of polling
2014-11-29 Workspace migration and some small bug fixes
    Should see updates as I made modifications now. Will need to have a sit
    down session to go over the general form of the source and do some
    cleanup.
    [Base.c, MspExp430F5137RxUserExperience_Backup.c, MspExp430F6137RxUserExperience.c, RF1A.c, RF1A.h, Satellite.c]
2014-12-11 Clean up, small bug fixes
    [Satellite.c]
2014-12-11 Local update of firmware on other device
2014-12-11 Inserted comment block on top
2014-12-11 Quick Fixes
    [ECE41112112014.csv]
2014-12-11 Added resizing based on most popular answer
    [ECE41112112014.csv]
2014-12-12 Changes, changes everywhere
    -changed bar graph resize to be off of total number of answers
    -implemented serial port checking for different base stations
    [ECE41112112014.csv]
2014-12-12 GitHub Maintenance
    File maintenance (moved all GERBER files in to folder, etc). BOM
    Presentable, GitHub file structure reasonable.
    [T08-TxClicker-Rev1a.brd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]
2014-12-12 More changes
    [ECE41112112014.csv]
2014-12-12 Trivial changes
    -added minimizing and restoring when polling and when polling is over,
    respectively
    [ECE411_21_04_26_12112014.csv]
2014-12-12 Lengthened wait time
    [ECE411_21_04_26_12112014.csv, ECE411_21_23_46_12112014.csv, ECE411_21_25_44_12112014.csv, ECE411_21_26_14_12112014.csv, ECE411_21_28_43_12112014.csv, ECE411_21_40_28_12112014.csv, ECE411_21_43_06_12112014.csv, ECE411_21_44_38_12112014.csv]
2014-12-12 ECE411 Presentation
    [ECE411_20_25_50_12112014.csv, T08-TxClicker-Rev1a.brd, T08-TxClicker-Rev1a.sch]
2014-12-13 Reviewed my section of WPRs
    Found a missing week hiding in the email stream and inserted. (I had
    titled the email with the wrong week)
2014-12-14 finalizing stuff
    [ECE411_20_25_50_12112014.csv, ECE411_21_23_46_12112014.csv, ECE411_21_25_44_12112014.csv, ECE411_21_26_14_12112014.csv, ECE411_21_28_43_12112014.csv, ECE411_21_40_28_12112014.csv, ECE411_21_43_06_12112014.csv, ECE411_21_44_38_12112014.csv]
2014-12-14 Picture of completed Rev A device
